ShashankT-ECE/cnn-accelerator/docs/PROJECT_STATE.md

# CNN Accelerator — Project State

## Current Status

### V2 generalized OS accelerator (branch `v2-dev`, `v2/`) — ACTIVE (updated 2026-09-28)

Current work is V2, a generalized INT8 8x8 output-stationary accelerator running LeNet-5 and CIFAR-10 end to end (frozen spec `v2/docs/ARCH_SPEC.md`; decisions `v2/docs/DECISIONS.md` D1–D18; plan `v2/docs/EXPERIMENTS.md`). Target: ROCS 2026 short paper (4 pages + refs, IEEE 2-col, single-blind), deadline 2026-10-09 AoE. The V1 material below is the frozen baseline (`v1-snapshot` / `v1-baseline`).

- **Verified (RTL sim / post-synth netlist sim):** bit-exact logits and cycle-exact agreement with the model on the network, layer, fuzz and checker suites; gate-level netlist sim cycle- and logit-exact; untruncated synthesis-log scan PASS. Counts: `v2/results/verification_stats.csv`.
- **Implementation (post-impl, build fd880d43):** 200, 250 and 300 MHz all close timing with 0 critical warnings. **Performance bitstream = 300 MHz, fallback = 250 MHz** (D14, D18). Numbers: `v2/results/impl_gos.csv`.
- **Results freeze (step 9) done 2026-09-28:** all producers re-run from one clean commit, `check_results.py` ALL CLEAN (results commit 8b8acce).
- **Paper pipeline (step 10):** `v2/paper/scripts/make_all.py` renders every table/figure from the CSVs; board cells are placeholders until hardware rows exist. Model analyses in `v2/analysis/` (utilization, V1-vs-V2 schedule ablation, 16x16 projection labeled "projected", not C1). Reproduction: `v2/REPRODUCE.md`.
- **Power plan:** primary = on-board INA260 SOM rail (VCC_SOM), `v2/board/power_log.py`, label "SOM-rail power (INA260)"; external meter optional cross-check.
- **Laptop-side reviewer gaps closed (2026-09-29):** full-dataset RTL sim 10,000/10,000 images per net bit- and cycle-exact (`rtl_full10k.csv`); publication-grade board sessions (pre-flight, measured PL clock, median + 95% CI, interleaving, repeatability, soak, spread, B2 fit, 300→250 fallback, fast host path, control phase, energy two ways; INA260 only, no external meter); DPU baseline compiled for the prebuilt pynq-dpu 2.5 overlay (`v2/dpu/`).
- **Next:** KV260 board sessions 1–3 + DPU session (`v2/board/session.sh`, `v2/dpu/dpu_session.py`) — nothing has been measured on the board yet; then the paper text.
- **Open questions:** INA260 real update rate and VCC_SOM rail coverage (confirm on the board / schematic); ΔP includes PS activity driving the accelerator.

### V1 (frozen baseline)

The repository baseline and shared development environment documentation are
established.

The project targets the AMD Kria KV260 / XCK26 using SystemVerilog and
Vivado ML 2023.1.

The repository is hosted on GitHub and is the shared source of truth for the
development team.

**Current engineering phase:** V1 systolic array implemented
(`rtl/common/systolic_array.sv`) and verified by its integration testbench
(`sim/tb_systolic_array.sv`, 379/379 checks PASS in Vivado ML 2023.1). Array
compile/elaboration is verified (`xvlog`/`xelab` clean), and the V1 PE remains
verified at 55/55 PASS. The systolic-array RTL + verification milestone is
complete, and DSP48E2 inference is established (1 DSP/PE, 64/array). The V1
Conv1 convolution mapping is resolved as a **row-decomposed 5-pass** schedule
(Decision 9), superseding a withdrawn single-pass 2-D mapping. The
input-feed/line-buffer specification is now unblocked; full array-level
integration (controller/BRAM/input-feed wiring) remains future work.

The V2 reconfigurable-dataflow systolic array (true spatial Weight-Stationary)
is also implemented and verified: `rtl/common/systolic_array_v2.sv` passes
335/335 checks in `sim/tb_systolic_array_v2.sv`, synthesizes to 64 DSP48E2 /
0 CARRY8, and closes timing at 200 MHz with post-route WNS +2.861 ns. Vivado
implements the muxed WS addend through the DSP C input (not PCIN/PCOUT) — see
Decision 12.

### Phase 2 Research Accelerator — COMPLETE (2026-08-21)

The Phase 2 research accelerator (`rtl/common/cnn_accelerator_v2.sv`) is
implemented and verified against the real MNIST-12 Conv1 (SAME-padded, OC=8)
golden model. It wraps the FROZEN V2 datapath (`systolic_array_v2.sv` /
`pe_v2.sv`, unchanged) with new integration logic providing:

- **Runtime OS/WS reconfiguration** on one datapath (Decision 14): 0=OS, 1=WS;
  mode_commit only in IDLE; 8-cycle flush; verified OS→WS and WS→OS bit-exact
  with no reset. OS = 9,184 cycles; WS dense = 38,528 cycles.
- **SAME padding** (zero injection for OOB rows/cols — fixes the Phase-1 clamp
  bug) and **OC=8** (all 8 PE rows in OS; 8 channel sweeps in WS).
- **Genuine coarse zero-skip** (Decision 16): a 5×12 all-zero activation window
  skips the whole WS group. Measured on real MNIST: 85.43% of MACs have zero
  activation; WS drops 38,528 → 18,368 cycles (2.10×). The frozen array's
  array-wide `zero_skip` is tied 0 (per-MAC gating is unsafe — gates the
  *shifted* product) and documented as a limitation.
- Exact `skipped/executed/total` MAC counters (156,800 / 133,960 / 22,840).

Integration testbench `sim/tb_cnn_accelerator_v2.sv` passes **75,305/75,305**
checks (OS/WS bit-exact vs golden, reconfiguration, padding boundaries, OC=8,
sparsity counters, mode interlock). Synthesis/implementation and timing are
recorded in `docs/PHASE2_SYNTHESIS.md`.

### Phase 2 Hardening — COMPLETE (2026-08-21)

The paper-readiness hardening milestone is complete and recorded in
`docs/PHASE2_HARDENING.md` (machine-readable artifacts in `data/benchmark/`).
All changes are localized to the Phase-2 controller (`cnn_accelerator_v2.sv`);
**no frozen module changed** and results remain bit-exact (75,305/75,305,
OS 9,184 / WS 18,368 cycles, counters 133,960/22,840/156,800 unchanged).

- **Timing:** WNS **+0.030 → +0.189 ns** @ 200 MHz (6.3× margin, ~208 MHz max)
  by registering `accum_clear`/`weight_load` at the array boundary, pipelining
  the MAC/cycle counters, expanding `result_base` as shifts (removes 3
  controller DSPs), and `max_fanout` on `s`/`mode_active_r`. Resources: LUT
  11,245→9,372, FF 5,726→5,795, DSP 67→64, CARRY8 20.
- **Fair OS/WS comparison:** OS 9,184 vs WS no-skip 38,528 = 4.195×; mechanism
  is WS channel serialization (8×) vs OS channel parallelism on rows.
- **Sparsity accounting:** 85.43% zero activations → 46.94% skippable MACs →
  52.33% cycle reduction → 2.10× (single image), 1.77× mean over 200 images.
  `zero_skip` per-MAC gating remains tied 0 (unsafe on the frozen array); the
  genuine mechanism is the coarse WS zero-group skip.
- **Accuracy:** FP32 == INT8 == 98.90% (0 flips, SQNR 46.44 dB, 0 clipping) on
  the full 10k test set; checkpoint SHA-256 pinned in `data/vectors/manifest.json`.
- **Reconfiguration:** 8-cycle flush (40 ns @ 200 MHz); OS→WS→OS and WS→OS→WS
  bit-exact, no reset.

### Phase 3 Board Integration — IMPLEMENTED + VERIFIED IN SIMULATION (2026-08-21)

The board-facing AXI4-Lite architecture (Decisions 17–20) is implemented and
verified in simulation; only physical measurement and bitstream generation
remain BOARD-ONLY. See `docs/PHASE3_BOARD_INTEGRATION.md` and
`docs/PHASE3_SYNTHESIS.md`.

- **New RTL:** `rtl/common/cnn_axi_ctrl.sv` (AXI4-Lite slave + result BRAM),
  `rtl/top/cnn_top.sv` (reset conversion + top).
- **New testbench:** `sim/tb_cnn_top_axi.sv` — 17/17 PASS (bit-exact vs golden).
- **New software:** `software/cnn_host.c` (PS UIO driver/benchmark), Makefile.
- **New scripts:** `scripts/run_verification.sh`, `scripts/board/*`
  (overlay + block-design template + firmware shell).
- **Reproducibility:** `golden_canonical.hex` now generated by
  `python/reference/export_vectors.py`; `data/vectors/SHA256SUMS` added;
  manifest `git_sha` re-pinned; `LICENSE` (MIT) added.
- **No frozen module modified.** `cnn_accelerator_v2.sv` gained one
  `sparsity_disable` input (non-frozen integration logic).

## Verified Development Environment

- Host OS: Ubuntu 22.04.5 LTS 64-bit
- Python: 3.10.12
- Vivado ML: 2023.1
- Target device: `xck26-sfvc784-2LV-c`
- PyTorch: 2.1.2+cpu
- torchvision: 0.16.2+cpu
- NumPy: 1.26.4
- Claude Code: 2.1.207
- Graphify: 0.8.39

## Repository Setup

Project-scoped Claude Code configuration is present under `.claude/`.

The shared development setup is documented in `docs/DEVELOPMENT_SETUP.md`.

The Research skill is included under `.claude/skills/research/`.

Generated build and local data must remain outside the committed source where
specified by `.gitignore`.

## Architecture Status

### Architecture Roadmap

The architecture roadmap is available locally at:

`docs/reference/architecture_major_project.pdf`
("CNN Hardware Accelerator on AMD Kria KV260 — Complete Project Reference v3.0")

It is a **local reference only** and has **not** been committed to Git. It is
the high-level project roadmap and initial reference. It is **not** an
authoritative detailed implementation specification.

Do not treat assumptions from the roadmap as finalized requirements.

### PE Specification

The first technical specification has been created and reviewed:

`docs/specs/PE_SPEC.md` — PE Specification (V1 Baseline)

This document records what the roadmap explicitly establishes, what external
research informs, candidate architectures, and open decisions. It uses a label
system: REQUIREMENT, RESEARCH FACT, CANDIDATE, IMPLIED, OPEN DECISION.

### PE Implementation and Verification

The V1 PE is implemented and functionally verified:

- **RTL:** `rtl/common/pe.sv` — implements the finalized V1 contract
  (`docs/specs/PE_SPEC.md` §5–§8; Decisions 1–6).
- **Testbench:** `sim/tb_pe.sv` — self-checking, non-UVM unit testbench.
- **Simulation:** Vivado ML 2023.1 (`xvlog`/`xelab`/`xsim`) — **55/55 checks
  PASS, 0 FAIL**.
- **Verified scenarios:** synchronous reset, weight load/retention/reload,
  signed 8×8 arithmetic and corner cases, 16→32-bit accumulation, repeated and
  back-to-back MAC, combinational activation forwarding, `zero_skip`,
  `result_request` read-without-clear, `accum_clear` pipeline flush, the §5.7
  control-priority combinations, and the finalized pipeline timing.

Synthesis (DSP48E2 inference) is **resolved** — see "Synthesis and DSP48E2
Inference" below. Array-level (`systolic_array.sv`) integration with the
controller/BRAM/input-feed remains future work.

### Systolic Array Specification

The V1 systolic array specification has been drafted:

`docs/specs/SYSTOLIC_ARRAY_SPEC.md` — Systolic Array Specification (V1 Baseline)

It records the resolved V1 dataflow (Decision 7): **Output-Stationary** —
weight-broadcast + activation-shift + local PE accumulation. It defines the 8×8
topology, the row/column mapping, the cycle-level schedule, the array interface,
and the verification requirements. It amends the roadmap's "fixed
weight-stationary" wording as historical/source context.

The five array scheduling decisions (Decision 8 — padding, skew, drain, tap
order, peak-vs-sustained) are also recorded, leaving `systolic_array.sv`
unblocked. The input-feed / line-buffer unit is a separate upcoming module.

### Systolic Array Implementation and Verification

The V1 systolic array is implemented and functionally verified:

- **RTL:** `rtl/common/systolic_array.sv` — an 8×8 grid of 64 verified PEs with
  array-level activation-shift interconnect (7 registers per row), per-row weight
  broadcast, array-wide control fan-out (`weight_load`/`accum_clear`/`zero_skip`),
  and column-sequential result drain. No FSM, no partial-sum cascade, no sparsity
  (per `docs/specs/SYSTOLIC_ARRAY_SPEC.md`).
- **Testbench:** `sim/tb_systolic_array.sv` — self-checking, directed, non-UVM,
  with an independent reference model (`PE(r,c) = Σ_t a_r[t]·w_r[t+c]`, streams
  zero-padded).
- **Simulation:** Vivado ML 2023.1 (`xvlog`/`xelab`/`xsim`) — **379/379 checks
  PASS, 0 FAIL**. Covers synchronous reset, 64-PE structure, activation shift and
  boundary columns, per-row weight broadcast, the one-cycle weight-lead skew,
  signed 8×8 arithmetic, 32-bit accumulation, `zero_skip`, `accum_clear`,
  column-sequential drain + read-without-clear, idle rows 6–7, back-to-back
  groups, and a complete deterministic convolution.
- **Compile/elaboration:** `xvlog -sv` and `xelab` on `pe.sv` + `systolic_array.sv`
  (+ testbench) are clean (0 errors).

The input-feed/line-buffer module is the next major module; full array-level
integration (controller/BRAM/input-feed wiring) remains future work.

### Systolic Array V2 Implementation and Verification

The V2 reconfigurable-dataflow systolic array (true spatial Weight-Stationary,
Decisions 10–11) is implemented and functionally verified:

- **RTL:** `rtl/common/systolic_array_v2.sv` — an 8×8 grid of 64 PE-v2 instances
  (`rtl/common/pe_v2.sv`) with the V1-identical activation shift chain, an
  explicit vertical `psum_in`/`psum_out` cascade, always-on bottom-to-top tile
  feedback (`psum_in[0][c] = psum_out[7][c]`), per-row weight broadcast, and a
  per-row (transposed) result drain that reads row 7. `dataflow_mode`/`zero_skip`
  are array-wide fan-out inputs; no FSM/controller/BRAM is instantiated.
- **Testbench:** `sim/tb_systolic_array_v2.sv` — self-checking, non-UVM, with an
  independent 5×5 valid-convolution golden model (never derived from the V2
  schedule / PE geometry / tile counters).
- **Simulation:** Vivado ML 2023.1 (`xvlog`/`xelab`/`xsim`) — **335/335 checks
  PASS, 0 FAIL**. Covers reset, weight load/hold, per-row diagonal skew, the
  vertical psum cascade (row-to-row / 2-PE / 8-row), all four tile partials at
  cycles 17/25/33/41, bottom-to-top tile feedback, tile-3 single tap, result
  capture timing, signed 8×8 corners, 32-bit accumulation, randomized cases, all
  8 output columns, boundary cases, multiple output rows, and multiple
  kernels/channels.
- **Compile/elaboration:** `xvlog -sv`/`xelab` clean (0 errors).

This establishes the true spatial Weight-Stationary dataflow (Decision 10) and
the Conv1 WS mapping (Decision 11) at array level. The controller/input-feed
internals that realize the §9 schedule remain future work.

### Systolic Array V2 Synthesis and DSP Mapping

- **DSP48E2 = 64** (1/PE), **CARRY8 = 0**, **BREG=1 / MREG=1 / PREG=1** for all
  64; AREG = 0/1/2 (activation shift-chain absorption, same mechanism as V1).
- **DSP addend mapping (RESOLVED):** the muxed WS addend (`psum_in + product`) is
  implemented through the DSP48E2 **C input** (OPMODE "C or P"), **not** the
  PCIN/PCOUT cascade, because the `dataflow_mode` mux prevents PCIN/PCOUT
  inference (confirmed in `build/dsp_probe/`: the mux-free `pe_ws` infers
  `PCIN+(A*B)`, the muxed `pe_dual` infers `(C or P)+(A*B)`). PCIN/PCOUT is an
  implementation detail, not a V2 functional requirement: the vertical psum
  reduction and bottom-to-top feedback are functionally verified and timing-clean
  regardless of which DSP input carries the addend. No PE redesign is required
  (Decision 12).
- **Post-route timing (200 MHz baseline):** WNS **+2.861 ns**, TNS 0 ns,
  WHS +0.073 ns, THS 0 ns, 0 failing endpoints, no congestion above level 5,
  0 unrouted nets. Critical path = the row-7 → row-0 tile-feedback hop via the
  C input (2.095 ns data delay, 2 logic levels). Resources: 64 DSP48E2 / 1,032
  LUT / 2,368 FF / 0 CARRY8 / 0 BRAM / 0 URAM.

### Synthesis and DSP48E2 Inference

DSP48E2 inference for the V1 PE and 8×8 array is established and verified
(Vivado ML 2023.1, target `xck26-sfvc784-2LV-c`):

- **Baseline (default synthesis):** Vivado's default `use_dsp = "auto"` mapped
  the signed 8×8 PE MAC entirely to fabric — **0 DSP48E2**, 97 LUT / 12 CARRY8
  per PE (array: 0 DSP, 7,054 LUT / 5,632 FF / 768 CARRY8). The 8×8 operands
  fall below Vivado's auto-DSP threshold (a DSP48E2 27×18 multiplier would be
  ~94% idle).
- **Root cause (controlled probes):** an 8×8 multiply and an 8×8 MAC each infer
  0 DSP48E2 under default synthesis; an explicit `(* use_dsp = "yes" *)` (or
  ≥16-bit operands) is required to obtain DSP48E2 inference. The PE's control
  gating (`rst`/`accum_clear`/`zero_skip`) is **not** the blocker.
- **Fix:** `rtl/common/pe.sv` adds a targeted `(* use_dsp = "yes" *)` attribute
  on the `product` datapath. No other behavioural change.
- **Single PE synthesis:** exactly **1 DSP48E2** — `AREG=0, BREG=1, MREG=1,
  PREG=1` (weight→BREG, product→MREG, accumulator→PREG, combinational
  activation→AREG=0). Fabric drops to 2 LUT / 0 CARRY8 / 32 FF (result_out
  only).
- **8×8 array synthesis:** exactly **64 DSP48E2** (1 per PE), 1,039 LUT /
  2,048 FF / 0 CARRY8 / 0 BRAM / 0 URAM. All DSPs use BREG=1, MREG=1, PREG=1;
  in the array Vivado may absorb the activation shift-chain registers into the
  DSP AREG inputs (observed AREG = 0/1/2 across columns), so AREG is not
  uniformly 0 at array level — functionally equivalent.
- **Functional verification unchanged:** `tb_pe` 55/55 PASS and
  `tb_systolic_array` 379/379 PASS (the attribute is a synthesis hint only;
  simulated behaviour is identical).

**RESOLVED:** DSP48E2 inference for the V1 PE/array is confirmed (1 DSP/PE,
64/array). Numerical format, accumulator width, and cycle-level behaviour are
unchanged.

### Post-Route Implementation Baseline

A baseline post-synthesis/post-route implementation of the V1 8×8 array was run
(Vivado ML 2023.1, top `systolic_array`, target `xck26-sfvc784-2LV-c`). This is
a timing/implementation baseline only — no RTL, pipeline, or constraint-source
changes were made.

- **Clock target (analysis only):** 200 MHz (5.000 ns), applied as a baseline
  constraint in the generated build flow only. This is **not** a finalized
  project clock requirement — the clock frequency target remains an open
  decision (`PE_SPEC.md` §11.6) until the controller/BRAM/input-feed
  integration is timed.
- **Implementation mode:** out-of-context (OOC). The flat `systolic_array`
  top exposes 397 I/O ports (256-bit `result_out` + 128 data inputs + control),
  which exceeds the ~189 bonded I/O sites available on the KV260/XCK26 package.
  This is expected: the array is a datapath sub-block intended to be driven by
  an on-chip controller/BRAM/PS-AXI interface, not by package pins. OOC isolates
  the internal register-to-register timing of the array core.
- **Post-route DSP count:** 64/64 DSP48E2 remain present after
  placement/routing.
- **DSP register configuration:** BREG=1, MREG=1, PREG=1 for all 64 DSPs.
- **AREG distribution:** AREG=0 × 8, AREG=1 × 40, AREG=2 × 16. The AREG=1/2
  DSPs reflect the array's activation shift-chain registers being absorbed into
  the DSP A-input registers (AREG absorption); the inter-column activation
  movement is realized via the DSP48E2 ACOUT→ACIN cascade.
- **Critical setup path:** DSP48E2_X11Y11 → DSP48E2_X11Y12, the DSP
  ACOUT→ACIN activation cascade between adjacent columns. The path is
  routing-dominated (~66% route vs ~34% logic of the 1.471 ns data delay, 0
  logic levels) and currently closes at the 200 MHz baseline target.
- **Post-route timing (200 MHz baseline):** WNS +2.772 ns, TNS 0 ns,
  WHS +0.115 ns. Setup, hold, and pulse-width constraints are all met (0 failing
  endpoints). 200 MHz closes with margin (~449 MHz setup-limited capability,
  with OOC clock skew estimated).
- **Resources (post-route):** 64 DSP48E2, 1,032 LUT, 2,048 FF, 0 CARRY8,
  0 BRAM, 0 URAM. The 2,048 FFs are the 64×32 `result_out` registers only; all
  other datapath registers (weight/product/accumulator/shift) live inside the
  DSPs.

**RESOLVED:** the V1 array datapath is timing-clean at the 200 MHz baseline and
DSP48E2 inference (64/64) is preserved through implementation.

## Decisions

### Established V1 PE Requirements (from Roadmap)

The architecture roadmap (§3.2, §4) establishes these V1 PE requirements:

- activation input
- weight input
- activation × weight multiplication
- internal accumulation
- FSM-controlled result exposure
- registered output
- zero_skip input port with functional bypass behaviour (port in V1;
  functional connection is Team A V2)
- 8×8 systolic grid (64 PE instances); activations shift across rows,
  weights shift down columns
- V1 baseline dataflow: Weight-Stationary (weights held in place,
  activations shift)

These are recorded in `docs/specs/PE_SPEC.md` §3.1 as R1–R9.

> Note: the "Weight-Stationary" dataflow label above is the roadmap's original
> wording. The V1 array dataflow was subsequently reclassified to
> Output-Stationary — see Decision 7.

### Numerical Format Status

**Decision 1 — Numerical Format — RESOLVED (2026-08-10).**

The V1 PE uses **signed 8-bit two's-complement integers** for both activation
and weight operands. The implicit scale factor is 1/256 (2^(-8)), making the
representable real range [-0.5, +0.49609375] with resolution 0.00390625.

This is the roadmap's "Q8" working assumption (§5.3), formally adopted as the
V1 numerical format.

| Parameter | Value |
|---|---|
| Activation operand | signed 8-bit two's-complement |
| Weight operand | signed 8-bit two's-complement |
| Operand width | 8 bits |
| Product width | 16 bits (full precision, not truncated inside PE) |
| Fixed-point interpretation | external to PE (array output / drain path) |
| Weight extraction | `w_fixed = clip(round(w × 256), -128, 127)` per roadmap §5.3 |

**Rationale:** consistent with roadmap weight extraction; minimal PE datapath
complexity (integer MAC only); optimal DSP48E2 mapping (one DSP/PE with 27×18
headroom); efficient BRAM usage (8 bits/weight); LeNet-5/MNIST accuracy loss
negligible with 8-bit quantization; preserves Q8→INT8 future-work pathway.

**Known risk:** weights with magnitude ≥ 0.5 are clipped. The team should
measure actual LeNet-5 weight distributions to assess accuracy impact.

### Decision 2 — Accumulator Width — RESOLVED (2026-08-10)

The V1 PE uses a **32-bit signed two's-complement accumulator**.

| Parameter | Value |
|---|---|
| Accumulator width | 32 bits signed |
| Minimum required (LeNet-5 conv1, N=25) | 21 bits |
| Industry standard (TPU, FINN, Jacob 2018) | 32 bits |
| Overflow threshold (worst-case products) | >131,000 |
| LeNet-5 worst case (FC1, N=400) | ~400 |
| DSP48E2 internal | 48 bits (native, "free") |

**Rationale:** Industry standard for 8-bit MAC arrays. 328× safety margin over
LeNet-5 worst case. Natural power-of-two width. DSP48E2 uses 48 bits
internally regardless; 32-bit RTL width governs behavioral simulation and PE
output routing. The exact per-PE accumulation depth (N_max_acc = 25 for conv1)
is not required to justify 32 bits — the margin is so large that any plausible
V1 mapping is safe.

### Decision 3 — Overflow Behaviour — RESOLVED (2026-08-10)

**No overflow handling logic in the V1 PE. Overflow is mathematically
impossible by construction.**

With 32-bit signed accumulator and 8-bit signed operands (max |product| =
16,384), the accumulator permits >131,000 worst-case accumulations before
overflow. LeNet-5 requires at most ~400 accumulations per PE. The safety
margin is 328×.

No wrap, saturation, or overflow-flag logic is implemented. The DSP48E2's
native 48-bit internal accumulator provides additional headroom internally.

### Decision 4 — Result-Read Protocol — RESOLVED (2026-08-10)

**FSM-driven strobe protocol with read-without-clear semantics.**

| Parameter | Value |
|---|---|
| FSM→PE signal | `result_request` (1 bit) |
| PE→FSM signal | `result_out` (32 bits, registered) |
| Accumulator clear | `accum_clear` (1 bit, separate from result_request) |
| Read semantics | Read-without-clear |
| Flow control | None in PE — FSM controls timing globally |
| Array-level drain | Column-sequential (8 PEs/cycle, 16 cycles: 2/column), outside PE scope |

**Rationale:** Simplest mechanism satisfying R5. Read-without-clear is
universal across all surveyed systolic accelerators. Separate `accum_clear`
preserves debugging capability. No valid/ready handshake in PE — consistent
with the roadmap's FSM-driven architecture.

### Decision 5 — Reset Semantics — RESOLVED (2026-08-10)

**Synchronous reset, active-high polarity (`rst`).**

| Parameter | Value |
|---|---|
| Synchronicity | Synchronous (`always_ff @(posedge clk)`) |
| Polarity | Active-high (`if (rst)`) |
| Registers reset | accumulator, weight, result_out |
| DSP48E2 mapping | Direct (native synchronous reset) |

**Rationale:** DSP48E2 registers support synchronous reset only (UG579, UG949).
Async reset would force MAC registers into fabric (~65 extra FFs + ~32 extra
LUTs per PE per UG949 example). Active-high matches DSP48E2 native reset
polarity. The roadmap's Skill 1 `negedge rst_n` is explicitly a code-gen
example, not a project requirement (per PE_SPEC.md §11.8).

### Decision 6 — Pipeline / Cycle Architecture — RESOLVED (2026-08-10)

**Registered MAC with combinational activation forwarding. Fixed depth.**

| Parameter | Value |
|---|---|
| MAC pipeline | DSP48E2-inferred, MREG=1, PREG=1 |
| MAC latency | 2 cycles (activation-in → accumulator-update) |
| Activation forwarding | Combinational (`act_out = act_in`, 0-cycle delay) |
| Weight register | 1 stage (`weight <= weight_in` on `weight_load`) |
| Result output | 1 stage (`result_out <= accumulator` on `result_request`) |
| Throughput | 1 MAC/cycle/PE (steady state) |
| Parameterization | Fixed (not parameterized for V1) |

**Rationale:** Simplest architecture satisfying all requirements (R1–R9).
MREG=1 is essential for timing and power (Xcell87). Combinational forwarding
eliminates pipeline alignment complexity. 2-cycle latency acceptable for CNN
inference (throughput matters, not latency). DSP48E2 inferred from behavioral
RTL. Fixed depth avoids premature parameterization.

### Decision 7 — V1 Dataflow Reclassification — RESOLVED (2026-08-17)

**The V1 array dataflow is Output-Stationary, not fixed spatial
Weight-Stationary.**

The architecture roadmap (§3.2, §4) describes V1 as "fixed weight-stationary:
weights held in place, activations shift." The finalized PE
(`rtl/common/pe.sv`) has a pinned local accumulator and no `psum_in`/`psum_out`
partial-sum path, so a literal fixed-weight dataflow would compute
`weight × Σ activations`, which is not a convolution. The completed array
specification (`docs/specs/SYSTOLIC_ARRAY_SPEC.md` §3) therefore establishes:

| Parameter | Value |
|---|---|
| V1 dataflow | Output-Stationary (tap-serial) |
| Weight movement | broadcast per row, reloaded every tap |
| Activation movement | shift across columns (array-level registers) |
| Partial-sum path | none in V1 |
| PE status | unchanged, verified (55/55) |
| True spatial Weight-Stationary | deferred to V2 / PE v1.1 (psum cascade) |

This **replaces** the earlier interpretation of V1 as fixed spatial
Weight-Stationary. The roadmap's "weight-stationary" wording is preserved as
historical/source context; the roadmap did not originally specify
Output-Stationary. This is an explicit architectural decision, not a silent
relabeling.

**Rationale:** the Output-Stationary mapping (weight-broadcast +
activation-shift + local accumulation) is the only dataflow that is both
mathematically correct for convolution and compatible with the locked PE; it
sustains one MAC/cycle/PE after pipeline fill. See
`docs/specs/SYSTOLIC_ARRAY_SPEC.md` §3 and §9.

### Decision 8 — V1 Array Scheduling Decisions — RESOLVED (2026-08-17)

Five array scheduling decisions are finalized (see
`docs/specs/SYSTOLIC_ARRAY_SPEC.md` §10, §11, §14–§17). `systolic_array.sv` is
now unblocked.

| # | Decision | Resolution | Rationale |
|---|---|---|---|
| 1 | Conv1 output dimension / padding | 24×24 valid (no padding) | Standard LeNet-5/MNIST; 24 = 3×8 → no partial tile |
| 2 | Weight/activation skew | weight stream leads activation by one cycle | Absorbs the PE BREG stage; §16 schedule |
| 3 | Result drain | column-sequential, 16 cycles (2/column) | Matches `result_request` protocol; 256-bit bus |
| 4 | Tap serialization | row-major `t = K·k_y + k_x` | Deterministic; shared by weight ROM and input feed |
| 5 | "64 MACs/cycle" | peak capability, not sustained | Conv1 sustains 48 (6 rows); rows 6–7 idle (75%) |

> **Amended by Decision 9 (2026-08-17):** items 4 and 5 above (single-pass
> row-major tap serialization; "48 MACs/cycle sustained") were found
> mathematically inconsistent / unjustified and are superseded. See Decision 9
> and `SYSTOLIC_ARRAY_SPEC.md` §20.4.

**Note:** the input-feed / line-buffer unit is a **separate upcoming module**
with its own specification. Its interface to the array (`act_in` sequence, tap
order, skew) is fully defined by the array spec; only its internals remain.

### Decision 9 — V1 Convolution Mapping (Row-Decomposed 5-Pass) — RESOLVED (2026-08-17)

The V1 Conv1 5×5 convolution is computed as **five sequential 1-D horizontal
passes**, one per kernel row `k_y = 0..4`, replacing the earlier single-pass
25-tap 2-D mapping.

| Parameter | Value |
|---|---|
| Convolution structure | 5 sequential 1-D passes (one per kernel row `k_y`) |
| Pass `k_y` | 1-D 5-tap horizontal correlation along input row `y + k_y` |
| Taps per pass | 5 (`k_x = 0..4`) |
| Accumulation | PE accumulator preserved across the 5 passes |
| `accum_clear` | only before pass 0 of a new output group |
| Result read | `result_request` after pass 4 (the 5th pass) |
| PE / array RTL | **unchanged** |

**Correction of a previous inconsistency.** The prior single-pass 25-tap 2-D
mapping (recorded in `SYSTOLIC_ARRAY_SPEC.md` §10.1/§16 and Decision 8) was
found **mathematically inconsistent** during the input-feed/line-buffer
specification work: with in-phase weight broadcast, a single shared activation
stream, and a 7-deep shift chain, the required activation value at one cycle
would have to equal two different input pixels. Numerical verification confirmed
column 0 correct and columns 1–7 incorrect. This is recorded as a **withdrawn
mapping** (with audit trail) in `SYSTOLIC_ARRAY_SPEC.md` §20.4 — not silently
relabelled.

**Why the error was not caught.** `sim/tb_systolic_array.sv`'s convolution test
(T11) used a 1-D 5-tap stimulus, which exercised the array mechanics but not the
2-D kernel-row boundary behaviour where the inconsistency occurs.

**Scope.** `rtl/common/pe.sv` and `rtl/common/systolic_array.sv` are unchanged;
the array performs a 1-D 5-tap correlation per pass and is unaware of the 2-D
structure. The controller/input-feed orchestrates the five passes.

**Storage and throughput are NOT finalized.** The input-feed's physical storage
(BRAM/URAM/distributed RAM) and the sustained throughput are not claimed here;
they must be derived from the input-feed/line-buffer specification (now
unblocked). The only derived storage fact is the 5×5 window data-span minimum
`(5−1)·28 + 5 = 117` pixels, treated as a data-availability lower bound, not a
physical line-buffer size.

**Rationale:** reuses the already-verified 1-D array behaviour directly; changes
only the controller/weight/activation schedule; no PE or array RTL change.

### Decision 10 — V2 Reconfigurable Dataflow (True Spatial Weight-Stationary) — RESOLVED (2026-08-18)

**V2's reconfigurable-dataflow mode is true spatial Weight-Stationary (WS).**
PE-v2 adds the partial-sum cascade ports required to implement it, and the V1
RTL is frozen and untouched.

| Parameter | Value |
|---|---|
| V2 WS dataflow | weights held in PEs + activation shift + vertical `psum_in`/`psum_out` cascade |
| Cross-tile reduction | bottom-to-top tile feedback (per-column feedback registers + row-0 mux) |
| PE-v2 added ports | `psum_in[31:0]` (input), `psum_out[31:0]` (output), `dataflow_mode` (input) |
| WS accumulator | `accumulator <= psum_in + product` (pass-through) |
| OS accumulator | `accumulator <= accumulator + product` (V1-identical) |
| Control priority | unchanged (`PE_SPEC.md` §5.7) |
| OS mode | behaviourally equivalent to V1 (`dataflow_mode = 0`) |

**V1 RTL frozen.** `rtl/common/pe.sv`, `rtl/common/systolic_array.sv`,
`rtl/common/input_feed.sv`, and the V1 testbenches (`sim/tb_pe.sv`,
`sim/tb_systolic_array.sv`, `sim/tb_input_feed.sv`) are **frozen and are not to
be modified** for V2. V2 introduces a new PE variant (PE-v2) and array-v2 rather
than editing the V1 modules.

**Why this supersedes the roadmap wording.** The roadmap §3.2 describes V2
"Mode 0 Weight Stationary" as "weights held, activations shift" with no partial
sums. Taken literally that computes `w × Σ activations`, which is not a
convolution (the same error withdrawn in Decision 9 / `SYSTOLIC_ARRAY_SPEC.md`
§20.4). True spatial WS requires the partial-sum cascade that Decision 7
deferred. PE-v2 adds the minimum ports so the array can reduce a 1-D dot product
across the vertical cascade and, via bottom-to-top tile feedback, deeper
reductions (e.g. Conv1's 25 taps across 4 tiles of ≤8). This is an explicit
decision, not a silent extension of the V1 PE.

**Contract.** The PE-v2 port list and accumulator semantics are specified in
`docs/specs/PE_SPEC.md` §13.

**Open V2 array-level items (not resolved by this decision):** WS weight-loading
mechanism, WS activation delivery, WS result collection, the reconfiguration
flush sequence, and DSP48E2 inference of the mode mux / PCIN–PCOUT cascade.

### Decision 11 — V2 WS Conv1 Mapping — RESOLVED (2026-08-19)

**The V2 Weight-Stationary Conv1 mapping is resolved** (see
`docs/specs/SYSTOLIC_ARRAY_V2_SPEC.md`). The earlier idea of mapping the **6
output channels onto PE rows 0–5** is **WITHDRAWN**: the PE-v2 vertical
`psum_in → psum_out` cascade **sums rows**, so rows-as-channels would produce
`Σ output[ch]` — the sum of six distinct channels, not six independent results.
In WS mode rows must therefore represent the **reduction/tap** dimension.

| Parameter | Value |
|---|---|
| PE rows 0–7 | kernel tap / reduction dimension (8 taps per tile) |
| PE columns 0–7 | 8 output pixels, V1 reverse-index mapping (`base − c`) |
| Output channels | serialized — one channel per sweep (6 sweeps for Conv1) |
| 25 taps | 4 WS tiles: 8 + 8 + 8 + 1 |
| Within a tile | `psum_in → psum_out` performs the vertical reduction |
| Bottom row | produces the running tile partial sum |
| Cross-tile feedback | bottom-to-top: `PE(0,c).psum_in = PE(7,c).psum_out` |
| Final result | bottom row (row 7), one completed output per column |

**Compatibility verified:** the bottom-to-top feedback is a valid systolic ring
(8 accumulator registers around the loop, no combinational loop) and is
realizable with the already-verified `rtl/common/pe_v2.sv` with **no PE change**;
`weight_load` reloads tap weights between tiles in both modes, and `accum_clear`
is asserted once per sweep (never between tiles), mirroring V1's pass sequencing.
The *cycle-level schedule* (V2 spec §9) and the `systolic_array_v2.sv`
interconnect are now implemented and verified (335/335; see Decision 12).

**Why this is a transposition, not a new datapath:** V1 holds channels on rows
and serializes taps in time; V2 WS holds taps on rows and serializes channels in
time. Columns (pixels) and the reverse index are unchanged; the V1 output-group
shape (6 × 8 = 48 results) is preserved.

### Decision 12 — V2 WS DSP Cascade Mapping (C input, not PCIN/PCOUT) — RESOLVED (2026-08-19)

**The V2 WS partial-sum cascade is implemented through the DSP48E2 C input, not
the PCIN/PCOUT cascade.** This resolves the "DSP48E2 inference of the mode mux /
PCIN–PCOUT cascade" verification gate (`PE_SPEC.md` §13.6 #5,
`SYSTOLIC_ARRAY_V2_SPEC.md` §10 #4).

| Parameter | Value |
|---|---|
| V2 WS dataflow | true spatial Weight-Stationary (Decisions 10–11) |
| Vertical psum reduction + tile feedback | functionally verified (335/335 array PASS) |
| WS addend DSP mapping | C input (OPMODE "C or P"), NOT PCIN/PCOUT |
| Root cause | the `dataflow_mode` mux prevents PCIN/PCOUT inference (mux-free `pe_ws` infers `PCIN+(A*B)`; muxed `pe_dual` infers `(C or P)+(A*B)`) |
| PCIN/PCOUT status | implementation detail, not a V2 functional requirement |
| PE redesign | not required |

**Why no change is made.** The `dataflow_mode` mux is the defining "reconfigurable
dataflow" feature of PE-v2; removing it to force PCIN/PCOUT would break OS↔WS
reconfigurability. The C-input mapping is functionally identical, synthesizes to
64 DSP48E2 / 0 CARRY8, and closes at 200 MHz (WNS +2.861 ns). No PE-v2 or
array-v2 redesign is warranted.

### Decision 13 — V2 Controller/Input-Feed Decisions — RESOLVED (2026-08-20)

The four remaining V2 array-level open items (result collection, weight loading,
reconfiguration flush, and tap flattening) are resolved against the frozen PE-v2
/ array-v2 interfaces and the verified 42-cycle/group schedule
(`docs/specs/SYSTOLIC_ARRAY_V2_SPEC.md` §9). Each uses the smallest V2-compatible
choice and adds **no new array or PE port**; no RTL is modified.

| # | Item | Resolution |
|---|---|---|
| 1 | Result collection | Reuse the existing per-row `result_req`: assert `result_req[7]` (row 7) for **one cycle** at cycle 41; capture `result_out[0:7]` at cycle 42. No dedicated bottom-row bus (it would modify the frozen array-v2). |
| 2 | Weight loading | Reuse `w_in[0:7]` + the single array-wide `weight_load` at cycles 0/15/23/31; per-tap weights from a small deterministic weight store (LUTROM/register file, ~150 weights ≈ 1.2 kb — no BRAM/URAM). The physical memory primitive is an input-feed implementation detail. |
| 3 | Reconfiguration flush | `accum_clear` at the group/sweep boundary (cycle 0) is the reconfiguration flush; full `rst` is the power-on reset only. `accum_clear` is **never** asserted between tiles (the ring must be preserved). |
| 4 | Tap flattening | **Row-major** `k = 5·k_y + k_x` (fixed, not just a working convention). Minimizes the input-feed's live-row window (≤3 kernel rows per tile vs 5 for column-major) and is already the verified golden-model order. |

These four close `SYSTOLIC_ARRAY_V2_SPEC.md` §10 items 1/2/3/5 and `PE_SPEC.md`
§13.6 items 1/3/4 (§13.6 item 2 was already resolved by §9.5; §13.6 item 5 by
Decision 12). The V2 controller/input-feed RTL that realizes the §9 schedule is
now unblocked; only its internals (activation line-buffer sizing, weight-store
primitive) remain future work.

### Decision 14 — Phase 2 Controller Architecture — RESOLVED (2026-08-21)

**The Phase 2 research accelerator is a single new integration module
(`rtl/common/cnn_accelerator_v2.sv`) driving the frozen `systolic_array_v2` in
both OS and WS modes, with SAME padding and OC=8.** No frozen module is
modified.

| Parameter | Value |
|---|---|
| Dataflow select | `dataflow_mode` (0=OS, 1=WS), latched to `mode_active` |
| Mode switch | `mode_commit` honoured only in IDLE; 8-cycle flush (`accum_clear` + 7-cycle shift-chain drain); no `rst` |
| OS mapping | rows = 8 output channels; 5-pass row-decomposed (Decision 9); 82 cyc/group × 112 groups = 9,184 cycles |
| WS mapping | rows = 8 taps/tile, 4 tiles; channels serialized (8 sweeps); 43 cyc/group × 896 groups = 38,528 cycles |
| Padding | zero injection via `row_ok`/`col_ok` predicate on the stream address (`-2` row/col offset) |
| OC=8 / 28×28 | 4 groups/row; `base = 7,15,23,31`; last group partial (4 valid pixels) |
| Result index | flat leftmost-pixel index `ch*784 + y*28 + (base-7)` (unambiguous for `base=31`) |

### Decision 15 — Result Encoding — RESOLVED (2026-08-21)

The result word carries `result_base = ch*784 + y*28 + (base-7)` (the group's
**leftmost** pixel flat index). A naive rightmost encoding
(`… + base`, `base=31`) overflows into the next row and is ambiguous; the
leftmost encoding (`base-7 ∈ {0,8,16,24}`) never overflows.

### Decision 16 — Sparsity Mechanism — RESOLVED (2026-08-21)

The frozen array's `zero_skip` is **array-wide** and gates the **product**
register, which samples the **shifted** activation (`act_delayed`), not the fed
stream. Gating it on the fed stream (`act_out==0`) zeroes legitimate in-flight
products (verified: sparse MNIST fails bit-exact). Therefore:

| Parameter | Value |
|---|---|
| `zero_skip` | tied to 0 (per-MAC gating unsafe on frozen array — documented) |
| Genuine mechanism | **coarse zero-group skip**: skip a WS group whose 5×12 activation window is all-zero (detected via a 784-bit non-zero mask maintained on image write) |
| Measured MNIST | 85.43% zero-activation MACs; 60/112 positions all-zero; WS 38,528 → 18,368 cycles (2.10×) |
| Counters | `total_macs`=156,800, `skipped_macs`=133,960, `executed_macs`=22,840, `cycle_count`, `zero_skip_cycles` |
| Rejected | fine-grained compaction (breaks fixed systolic timing) |

### Decision 17 — Measured WS-dense via `sparsity_disable` — RESOLVED (2026-08-21)

**A `sparsity_disable` control input is added to `cnn_accelerator_v2` (Phase-2
integration logic — not frozen), so the Weight-Stationary no-skip cycle bound is
MEASURED in simulation rather than asserted analytically.** Default 0 preserves
the coarse zero-group skip; `sparsity_disable=1` forces WS to run all 896 groups.

| Parameter | Value |
|---|---|
| WS dense (sparsity_disable=1) | **38,528 cycles, bit-exact [SIMULATION]** |
| WS sparse (sparsity_disable=0) | 18,368 cycles [SIMULATION] |
| OS dense | 9,184 cycles [SIMULATION] |
| Effect on the frozen datapath | none (2-input AND on the `ws_skip` predicate) |

This converts the paper's central WS-dense row from `[ANALYTICAL] no-skip bound`
to `[SIMULATION] sparsity_disable=1`, closing the "WS-dense is analytical not
measured" reproducibility gap. `benchmark_matrix.json` provenance updated.

### Decision 18 — A1 fair-WS ablation resolved by analysis — RESOLVED (2026-08-21)

**The `A1` "pipelined-V2" ablation (`RESEARCH_READINESS_PLAN.md` §1/§11) is
resolved by analysis, not implementation.** The Phase-2 WS bubble analysis
(`PHASE2_HARDENING.md` §3) shows the only recoverable bubble is group-boundary
pipelining = 1 cycle/group ≈ 2.3%, which cannot change the 4.195× OS-vs-WS
conclusion (whose mechanism is 8× channel serialization vs ~1.9× shorter group).
Implementing a schedule change for a 2.3% effect is neither technically safe
(risk to bit-exactness) nor scientifically necessary (the conclusion is robust).
The like-for-like comparison is already fair: OS-on-array-v2 is bit-identical to
V1 (`pe_v2.sv` OS mode), on the same 64 DSP48E2 / same clock / same golden.

### Decision 19 — Board-facing AXI4-Lite architecture — RESOLVED (2026-08-21)

**The board-facing architecture wraps the verified accelerator in an AXI4-Lite
slave** (per `RESEARCH_READINESS_PLAN.md` §7 Option A, §8): `cnn_axi_ctrl.sv`
(slave + register file + result BRAM + accelerator instance) and `cnn_top.sv`
(`aresetn`→`rst` conversion). Details in `docs/PHASE3_BOARD_INTEGRATION.md`.
Runtime OS↔WS switching is now reachable by software via `DATAFLOW_MODE` +
`CONTROL.MODE_COMMIT` (previously only by testbench pins). Verified 17/17 PASS
in `sim/tb_cnn_top_axi.sv` (image/weight AXI load, OS/WS/WS-dense cycle counts
9,184/18,368/38,528, 6,272/6,272 bit-exact per mode, runtime switch, counters).

### Decision 20 — Result storage (8-bank canonical BRAM) — RESOLVED (2026-08-21)

**Results are stored in 8 single-write-port BRAMs, one per column residue
`x & 7`, at dense address `flat >> 3`** (`flat = ch*784+y*28+x`). Pixel `c` of a
result word maps to bank `7-c`, dense `(result_base+7-c)>>3`. This gives 8
parallel single-write ports (1 result word/cycle, no FIFO/backpressure) and
re-orders results into canonical order in hardware, so host software reads
straight through with **no reverse-index decode**. The group-leftmost column is
`result_base % 28` (784 = 28·28); pixel validity is `left ≤ 20+c`.

### Decision 21 — License — RESOLVED (2026-08-21, changeable)

**The repository now carries an MIT license** (`LICENSE`), matching the MIT
ONNX-MNIST-12 checkpoint and the norm for academic FPGA code. This is a
low-risk default for publication-ready redistribution; the team may choose a
different license before first public release.

### Unresolved PE Decisions

The following decisions block `rtl/common/pe.sv` implementation (see
`docs/specs/PE_SPEC.md` §11–§12 for full context):

1. ~~Numerical format finalisation~~ **RESOLVED (2026-08-10)**
2. ~~Accumulator width~~ **RESOLVED (2026-08-10) — 32-bit signed**
3. ~~Product representation~~ **RESOLVED — 16-bit full precision (consequence of Decision 1)**
4. ~~Overflow behaviour (or explicit waiver)~~ **RESOLVED (2026-08-10) — overflow impossible by construction**
5. ~~Result-read protocol (FSM↔PE handshake)~~ **RESOLVED (2026-08-10) — result_request strobe, read-without-clear**
6. ~~Reset semantics (polarity, synchronicity)~~ **RESOLVED (2026-08-10) — synchronous, active-high (rst)**
7. ~~Pipeline depth / cycle-level behaviour~~ **RESOLVED (2026-08-10) — registered MAC, combinational forwarding, fixed depth**

These are **not** finalized:
- clock frequency target
- exact RTL signal names
- `wgt_out` port
- V2 dataflow-controller extensibility hooks

### V1 / V2 Distinction

- **V1** is the shared baseline: **Output-Stationary** dataflow
  (weight-broadcast + activation-shift + local accumulation), no sparsity
  (Decision 7).
- **True spatial Weight-Stationary** (partial-sum cascade, `psum_in`/`psum_out`)
  is the V2 reconfigurable-dataflow mode — **DECIDED (Decision 10, 2026-08-18)**,
  superseding the earlier "deferred to V2 / PE v1.1" status. PE-v2 adds
  `psum_in`/`psum_out`/`dataflow_mode`.
- **Team B reconfigurable dataflow** (per-layer WS/OS mode switching) is a V2
  extension; its Weight-Stationary mode uses the psum cascade defined by
  Decision 10.
- **Team A sparsity** is a V2 extension. The V1 PE has the `zero_skip`
  port, but its functional connection to the Sparsity Manager is a V2
  Team A concern.

### Previously Undecided — Now Established

| Parameter | Previous Status | Current Status |
|---|---|---|
| PE count | Undecided | **Established:** 64 (8×8 grid) per roadmap §3.2 |
| V1 dataflow mode | Undecided | **Established:** Output-Stationary (weight-broadcast + activation-shift + local accumulation) per Decision 7; roadmap §3.2 "weight-stationary" wording superseded |
| Numerical format | Undecided | **Established:** Signed 8-bit two's-complement, scale 1/256 (Decision 1, 2026-08-10) |
| Accumulator width | Undecided | **Established:** 32-bit signed two's-complement (Decision 2, 2026-08-10) |
| Overflow behaviour | Undecided | **Established:** Overflow impossible by construction; no handling logic (Decision 3, 2026-08-10) |
| Result-read protocol | Undecided | **Established:** result_request strobe, read-without-clear, separate accum_clear (Decision 4, 2026-08-10) |
| Reset semantics | Undecided | **Established:** synchronous, active-high (rst) (Decision 5, 2026-08-10) |
| Pipeline architecture | Undecided | **Established:** registered MAC (MREG+PREG), combinational forwarding, fixed depth (Decision 6, 2026-08-10) |
| PE forwarding direction | Undecided | **Established:** activations shift across rows per roadmap §3.2 |
| Conv1 output dimension | Undecided | **Established:** 24×24 valid, no padding (Decision 8, 2026-08-17) |
| Weight/activation skew | Undecided | **Established:** weight stream leads activation by one cycle (Decision 8, 2026-08-17) |
| Result drain | Undecided | **Established:** column-sequential, 16 cycles (2/column) (Decision 8, 2026-08-17) |
| Kernel serialization | Undecided | **Established:** row-major `k_y, k_x` indexing, **decomposed into 5 passes** (Decision 9, 2026-08-17; amends the withdrawn single-pass 25-tap stream) |
| "64 MACs/cycle" meaning | Undecided | **Established:** peak capability; sustained throughput re-derived under the 5-pass mapping (Decision 9, 2026-08-17) |
| Conv1 convolution mapping | Incorrect (single-pass 2-D) | **Established:** row-decomposed 5-pass, one 1-D pass per kernel row (Decision 9, 2026-08-17) |

## Open Questions

Record unresolved architectural or implementation questions here as they
arise.

## Milestones

1. Repository baseline and dev environment documentation — **complete**
2. PE specification (`docs/specs/PE_SPEC.md`) — **complete** (draft, reviewed)
3. Numerical format decision — **complete** (2026-08-10)
4. Accumulator width, overflow, result-read decisions — **complete** (2026-08-10)
5. Reset semantics, pipeline architecture decisions — **complete** (2026-08-10)
6. **All six PE-blocking decisions resolved.** RTL entry criteria satisfied.
7. V1 PE RTL implementation (`rtl/common/pe.sv`) — **complete**
8. V1 PE unit testbench (`sim/tb_pe.sv`) — **complete** (55/55 PASS in simulation)
9. V1 systolic array specification (`docs/specs/SYSTOLIC_ARRAY_SPEC.md`) and
   dataflow decision (Decision 7) — **complete** (2026-08-17)
10. V1 array scheduling decisions (Decision 8) — **complete** (2026-08-17);
    `systolic_array.sv` unblocked
11. Systolic array RTL (`rtl/common/systolic_array.sv`) — **complete**
12. V1 systolic-array testbench (`sim/tb_systolic_array.sv`) — **complete**
    (379/379 PASS in Vivado ML 2023.1)
13. Input-feed / line-buffer module (separate spec + RTL) — **complete**
    (`rtl/common/input_feed.sv` + `sim/tb_input_feed.sv` +
    `docs/specs/INPUT_FEED_SPEC.md`; unblocked by Decision 9)
14. Synthesis/DSP48E2 inference — **complete** (1 DSP/PE, 64/array); full
    array-level integration (controller/BRAM/input-feed) — **pending**
15. V1 convolution mapping decision (row-decomposed 5-pass) — **complete**
    (2026-08-17); supersedes the withdrawn single-pass 2-D schedule
16. Team B V2 extensions (reconfigurable dataflow: PE-v2 + systolic-array-v2) —
    **complete** (335/335 PASS, 64 DSP48E2, 200 MHz WNS +2.861 ns); Team A V2
    sparsity extension — **pending**
17. V2 controller/input-feed (realizes the §9 WS schedule) — **pending**
    (unblocked by Decision 13)

## Next Planned Work

1. ~~**Decision 1: numerical format.**~~ **COMPLETE (2026-08-10).**
2. ~~**Decisions 2–4: accumulator width, overflow, result-read.**~~ **COMPLETE (2026-08-10).**
3. ~~**Decisions 5–6: reset semantics, pipeline architecture.**~~ **COMPLETE (2026-08-10).**
4. ~~**V1 PE RTL implementation.**~~ **COMPLETE** — `rtl/common/pe.sv` implemented.
5. ~~**V1 PE unit testbench.**~~ **COMPLETE** — `sim/tb_pe.sv`; Vivado 2023.1
   simulation passes 55/55.
6. ~~**V1 systolic array specification + dataflow decision.**~~ **COMPLETE** —
   `docs/specs/SYSTOLIC_ARRAY_SPEC.md` (draft); Decision 7 recorded (2026-08-17).
7. ~~**Resolve the array's scheduling decisions.**~~ **COMPLETE** — Decision 8
   (padding, skew, drain, tap order, peak-vs-sustained) recorded (2026-08-17).
8. ~~**Systolic array implementation + array-level verification.**~~ **COMPLETE** —
   `rtl/common/systolic_array.sv` + `sim/tb_systolic_array.sv`; Vivado 2023.1
   simulation passes 379/379.
9. ~~**Input-feed / line-buffer module specification and RTL.**~~ **COMPLETE** —
   `rtl/common/input_feed.sv` + `sim/tb_input_feed.sv` +
   `docs/specs/INPUT_FEED_SPEC.md` (spec unblocked by Decision 9).
10. ~~**Vivado synthesis and DSP48E2 inference check on the target device.**~~
    **COMPLETE** — 1 DSP48E2/PE, 64/array (`use_dsp` attribute required for 8×8).
11. ~~**V1 convolution mapping (row-decomposed 5-pass).**~~ **COMPLETE** —
    Decision 9 recorded (2026-08-17); supersedes the withdrawn single-pass 2-D
    schedule.
12. **V2 controller/input-feed internals** that realize the §9 WS schedule
    (`docs/specs/SYSTOLIC_ARRAY_V2_SPEC.md` §9) — unblocked by Decision 13
    (2026-08-20).

## Research Discipline

- Distinguish roadmap requirements from external research facts.
- Distinguish research facts from engineering recommendations.
- Do not allow common CNN accelerator practice to become a project
  requirement without an explicit team decision.
- Do not over-engineer infrastructure before it is needed; prioritise
  accelerator architecture and RTL development.
