ShashankT-ECE/cnn-accelerator/v2/tb/README.md

# tb — Self-checking xsim testbenches, one per RTL module; each prints PASS/FAIL and exits nonzero on failure.
