ShashankT-ECE/cnn-accelerator/v2/paper/PAPER_PLAN.md

# ROCS 2026 Paper Plan — KV260 CNN Accelerator

Sep 30, 2026 · @shashank

> Converted from the PDF "ROCS 2026 Paper Plan — KV260 CNN Accelerator" (10 pages,
> downloaded 2026-10-02) to Markdown. The text is unchanged except for layout.
> This file is the source of truth for structure, thesis, page budgets, writing
> rules and final numbers.
>
> **Corrections (2026-10-02, checked against the results CSVs):** requantization is
> "verified bit-exact on every non-saturating input" (139.6M values exhaustive, 486.6M
> in total with the saturation boundaries and samples; `requant_equivalence.csv`), not
> "proven over all ~475M reachable inputs" (475M was the CIFAR-10 r1 count); 2 of 354
> channels needed a 1-LSB adjustment of m (near-ties), not 3 (DECISIONS D1 outcome);
> best-CPU energy CIFAR-10 0.895 mJ (`tab_b1_power`), not 0.893; 16.5k LUTs (16,538);
> the limits audit is 49 boundary cases (`limits_rtl.csv`). The text below is updated.

## Submission facts

We submit a short paper to ROCS 2026, due October 9, 2026 AoE (about 5:30 PM IST on
October 10). CFP

| Item | Detail |
|---|---|
| Venue | ROCS 2026 workshop at IEEE HiPC 2026, Bengaluru, Dec 16 |
| Track | Short paper (fallback: 2-page poster abstract) |
| Length | 4 pages excluding references; figures count toward the 4 pages |
| Format | IEEE conference template (IEEEtran), two-column, 10 pt |
| Review | Single-blind, at least 3 reviewers. Author names stay on the paper |
| Submit | Linklings, select the ROCS track |
| Notification | November 6, 2026 |
| Camera-ready | November 13, 2026 (firm) |
| If accepted | One author presents in person; one full HiPC 2026 registration required |
| Publication | HiPC Workshops proceedings and IEEE Xplore. Authors can opt out at camera-ready and keep the right to publish an extended version elsewhere |

The CFP themes that fit us are "AI/ML on FPGAs: CNNs" and "case studies, reproducibility
and lessons learned".

## Thesis and title

**Thesis:** a small INT8 accelerator on the KV260 whose performance is exactly predictable.
Its analytical cycle model, its RTL and the real board agree to the cycle on every layer, and
its outputs are bit-exact against the reference.

We do not compete on raw throughput. Our strengths are exactness, determinism, honest
measurement and reproducibility. Every section should support that.

**Comparison position (final):** against the AMD DPU we are 1.5× faster on LeNet-5 at half
its energy per image, and 1.6× slower on CIFAR-10 at equal energy, while the loaded design
adds about 0.23 W at idle against the DPU's 1.15 W. Against the best CPU (ONNX Runtime
INT8, 4 threads) we are 2.1–3.1× faster and use 5.5–7× less energy. Never claim to beat the
DPU overall; lead with exactness, zero-spread compute latency and energy, and state the
DPU's CIFAR-10 latency win plainly. End-to-end spread comes from the Python host, so
the determinism claim applies to accelerator compute only.

**Working titles (pick one):**

1. Predictable by Construction: A Cycle-Exact, Bit-Exact INT8 CNN Accelerator on the
   Kria KV260
2. When the Model Is the Hardware: Cycle-Exact Performance Prediction for an FPGA
   CNN Accelerator
3. From Analytical Model to Silicon: A Verified, Deterministic INT8 CNN Accelerator on
   the KV260

**Contributions** (these become the bullet list at the end of the introduction):

1. An 8×8 output-stationary INT8 accelerator on the KV260 with a requantization
   contract verified bit-exact on every non-saturating input (139.6M values exhaustive,
   486.6M in total).
2. An analytical cycle model, with constants fixed before the RTL was simulated, that
   predicts every layer's cycles exactly: on 20,000 test images, 286 random layer jobs, and
   the board.
3. A board evaluation on the same KV260: deterministic latency, SOM-rail energy, a
   7-point clock sweep, and comparison with the on-board ARM CPU and the AMD DPU.
4. A fully reproducible artifact: every reported number is generated by script from a
   tagged commit, with hashed logs.

## Draft abstract

About 180 words. Bracketed values come from the board; everything else is already
measured or verified.

> FPGA accelerator papers often report performance from models or simulation,
> leaving the gap to real hardware unquantified. We present an INT8 CNN accelerator
> for the AMD Kria KV260 whose performance is exactly predictable. An 8×8 output-
> stationary array of DSP48E2 slices runs LeNet-5 and a CIFAR-10 network entirely on
> chip at 250 MHz, using 80 DSPs and 16.5k LUTs. Its requantization is verified bit-exact
> against the floating-point reference on every non-saturating input. An analytical
> cycle model, fixed before RTL simulation, predicts per-layer cycle counts with zero
> error across 20,000 test images and 286 random layer configurations in RTL
> simulation, and [on the KV260 board]. Measured on the board, inference takes [X] µs
> for LeNet-5 and [Y] µs for CIFAR-10, with [zero] latency variation, at [Z] µJ per image
> of SOM-rail energy. It is [A]× faster than the on-board Cortex-A53 and [B] against the
> AMD DPU. All results are regenerated by script from a tagged commit.

Rules for the final version: replace every bracket with the measured value, and delete any
claim the board does not confirm.

## Structure and page budget

Eight sections in 4 pages, which is 8 columns. Six of the eight can be written now; only
Results and part of the Abstract need the board.

| # | Section | Columns | Figures / tables | Write now? |
|---|---|---|---|---|
| — | Abstract | 0.4 | — | Draft yes, final numbers after board |
| I | Introduction | 0.8 | — | Yes |
| II | Related work | 0.5 | — | Yes (needs literature search) |
| III | Architecture | 1.3 | Fig. 1 block diagram | Yes |
| IV | Cycle model | 0.6 | — | Yes |
| V | Verification methodology | 1.0 | Fig. 2 verification flow | Yes |
| VI | Experimental setup | 0.5 | Table I implementation | Yes |
| VII | Results | 2.4 | Fig. 3 agreement, Fig. 4 shapes, Table II results | After board |
| VIII | Conclusion and limitations | 0.4 | — | Mostly yes |
| | References | extra pages | — | Yes |

If we run over, cut in this order: Fig. 2, then Related work down to 0.3 columns, then the
clock sweep to one sentence.

## Section-by-section content

Each section lists what it must say. "Now" means writable today from laptop results;
"Board" means it waits for measurements.

### I. Introduction (Now)

1. Problem: FPGA CNN accelerator papers often report modeled or simulated
   performance; the gap to real hardware is rarely quantified.
2. Why it matters: predictable latency matters for embedded and real-time use; a model
   you can trust enables design-space exploration without building every design.
3. Our approach: build the model first, fix its constants before simulation, then hold RTL
   and board to it cycle for cycle.
4. Contributions list (from the Thesis section).
5. One sentence on scope: small networks by design; the claim is exactness, not peak
   throughput.

### II. Related work (Now, needs literature search)

1. FPGA CNN accelerators (output-stationary and systolic designs, small-network edge
   accelerators).
2. Analytical performance models for accelerators and how closely they have matched
   hardware.
3. Vendor IP: the AMD DPU on Kria.
4. Verification and reproducibility practice in FPGA research.

End with one sentence on the gap we fill: few works show model, RTL and board agreeing
exactly. Do not cite anything we haven't read.

### III. Architecture (Now)

1. Numeric contract: signed INT8, zero-point 0, per-tensor activation scales, per-output-
   channel weight scales, INT32 accumulation. Requantization = (acc + q_bias) × m,
   round-half-to-even shift by s, clip, ReLU. Final layer exports raw INT32 logits.
2. Datapath: 8×8 output-stationary outer-product array; rows = 8 consecutive output x
   positions, columns = 8 output channels; each PE is one DSP48E2. Double-buffered
   drain overlapped with the next tile. 8 requant lanes, fused 2×2 max-pool.
3. Memory: everything on-chip in BRAM, no DRAM traffic during inference. Ping-pong
   activation buffers banked by x mod 8 with a kx rotator for conflict-free reads; all
   weights resident.
4. Control: counter-only address generation (no multipliers), token pipeline, descriptor
   sequencer for up to 8 layers per start, pipelined config checker.
5. Interface: AXI-Lite CSR with cycle, MAC-active and stall counters, per-layer cycle
   registers, logits, BUILD_ID; loaded as a PYNQ overlay.
6. Supported shapes: VALID convolution, stride 1, kernel width ≤ 9 (host-enforced;
   verified at the boundary in RTL simulation).

### IV. Cycle model (Now)

1. Tiling order and tile count: T = ceil(OC/8) × OH × ceil(OW/8).
2. Per-layer cycles = T × K + C_PIPE (29), where K = IC × KH × KW; plus C_START (3) per
   job.
3. Constants were committed before the first RTL simulation.
4. Utilization analysis: 39.6% (LeNet) and 67.3% (CIFAR), lost mostly to partial 8-wide
   tiles; layers with a 1×1 output capped at 12.5%, 10-class final layers at 7.8%. This is the
   known output-stationary limit.
5. Ablation (model): a per-kernel-row schedule would take 1.83× (LeNet) and 2.16×
   (CIFAR) the cycles.

### V. Verification methodology (Now)

1. Requantization verified bit-exact on every non-saturating input (139.6M values
   exhaustive, 486.6M in total); 2 of 354 channels needed a 1-LSB adjustment of m
   (near-ties of the rounded multiplier).
2. Golden model matches the legacy reference on all 10k images of both networks.
3. Full-dataset RTL simulation: 20,000 images bit-exact and cycle-exact, Verilator cross-
   checked against xsim.
4. Random-shape validation: 300 seeded jobs in 13 categories; all 286 valid jobs bit-exact
   and cycle-exact; all 14 invalid jobs correctly refused.
5. Robustness: 100 back-to-back AXI jobs including a refused job and a mid-job soft reset;
   post-synthesis netlist simulation.
6. What verification found: random shapes revealed an unchecked kernel-width limit,
   now host-enforced. A follow-up audit boundary-tested the descriptor fields in 49 cases
   in two simulators and added host checks wherever the hardware checker has a gap.
   One or two sentences; it shows the method works.
7. Provenance: every number is script-generated from a clean commit with bitstream
   SHA256 and BUILD_ID; logs archived with hashes.

### VI. Experimental setup (Now)

1. Board: KV260 (K26 SOM), Kria Ubuntu 22.04, Kria-PYNQ. Clock: 250 MHz, set from the
   PS PLL and verified by read-back; all µs values use the read-back clock. The design also
   closes timing at 300 MHz, but the KV260's default PS PLL (999.99 MHz) cannot divide
   to it.
2. Implementation table (Table I).
3. Protocol: CPU governor fixed, cores pinned, warm-up discarded, ≥100 repeats, median
   with 95% CI, interleaved conditions.
4. Power: SOM-rail INA260 (VCC_SOM); idle, accelerator, control and CPU phases; energy
   = ΔP × time.
5. Baselines: Cortex-A53 (numpy INT8/FP32, ONNX Runtime FP32/INT8, 1 and 4 threads);
   AMD DPU with the prebuilt pynq_dpu 2.5 overlay.

### VII. Results (Board)

1. Three-way agreement: per-layer cycles model = RTL = board; spread across 10k images
   (Fig. 3).
2. Correctness: 0 logit mismatches on 10k images per net; accuracy equals golden.
3. Latency and throughput: compute-only and end-to-end p50/p95/p99; images/s.
4. Energy: µJ per image, GOPS/W, SOM-rail.
5. Comparison: CPU and DPU on the same board (Table II). Lead with determinism and
   latency, report throughput honestly.
6. Generality: random-shape predicted vs measured cycles (Fig. 4).
7. Clock sweep: cycles constant, latency ∝ 1/f, static vs dynamic power fit. One or two
   sentences.

### VIII. Conclusion and limitations (Mostly now)

1. Restate the claim with the headline numbers.
2. Limitations: small networks; VALID, stride 1 only; single 8×8 array; SOM-rail power
   includes the CPU driving the accelerator.
3. Future work: padding and stride, 16×16 array, larger networks.

## Figures and tables

Four pages hold about four figures and two tables. Data figures and tables come from the
repo's paper pipeline (v2/paper/); only Fig. 1 and Fig. 2 are drawn by hand.

| ID | Content | Source | Status |
|---|---|---|---|
| Fig. 1 | Architecture block diagram: PS, AXI, CSR, buffers, 8×8 array, requant, pool | Draw by hand (draw.io or TikZ) | Start now |
| Fig. 2 | Verification and provenance flow: model → RTL → board, with checks at each step | Draw by hand | Start now; first to cut |
| Fig. 3 | Per-layer cycles, model vs RTL vs board, both nets (the key figure) | Pipeline (A3) | Model and RTL done; board pending |
| Fig. 4 | Predicted vs measured cycles for random shapes (y = x) | Pipeline (fig_shapes_cycles) | RTL done; board pending |
| Table I | Implementation: clock, WNS/WHS, LUT, FF, DSP, BRAM | Pipeline (T1) | Done |
| Table II | Results vs baselines: accuracy, latency p50/p99, throughput, energy per image, GOPS/W for accelerator, A53 and DPU | Pipeline | Board pending |

Optional if space allows: the clock-sweep plot, as a small inset or one sentence.

**Revision 2026-10-02 (fit to 4 pages):** Fig. 2 is dropped (its content is two sentences
at the start of Section V), so the data figures are numbered Fig. 2 (per-layer cycles,
`fig_a3_cycles`) and Fig. 3 (random shapes, `fig_shapes_cycles`). Fig. 1 is TikZ
(`tex/sections/fig_arch.tex`). Table I = `tab_impl_compact` (250 MHz build only, 300 MHz
as a note). Table II = `tab_compare` (ours / DPU / best CPU per net: e2e p50, SOM-rail
energy per image, speedup vs the best CPU baseline). GOPS/W is not reported. Section IV
defines one utilization metric (PE utilization = useful MACs / (64 × TOTAL_CYC)).

## Final numbers (frozen Oct 2)

Experiments are frozen at tag v2-paper-freeze. All board numbers are measured on the
KV260 at 250 MHz; power is SOM-rail (INA260). Final paper values come from the pipeline
(median across 3 sessions); these are for writing.

| Quantity | LeNet-5 | CIFAR-10 |
|---|---|---|
| Accuracy, model = board (10k images, bit-exact) | 98.79% | 78.52% |
| Cycles, model = RTL = board (20k images, zero spread) | 16,436 | 104,247 |
| Accelerator compute latency | 65.7 µs | 417.0 µs |
| End-to-end latency, fast host path (median) | 224.5 µs | 578.5 µs |
| Best CPU, ONNX Runtime INT8 ×4 (median) | 695 µs | 1228 µs |
| Speedup vs best CPU, end-to-end | 3.1× | 2.1× |
| DPU end-to-end (median) | 346 µs | 353 µs |
| Accelerator vs DPU, end-to-end | 1.5× faster | 1.6× slower |
| Energy per image: ours / DPU / best CPU | 0.065 / 0.124 / 0.454 mJ | 0.161 / 0.166 / 0.895 mJ |
| Throughput (compute) | 15,210 img/s, 12.7 GOPS | 2,398 img/s, 21.6 GOPS |

| Robustness and repeatability | Value |
|---|---|
| Random layer shapes | 286/286 exact on the board; 14/14 invalid jobs refused |
| Soak test | 3.65M inferences in 30 min, 0 errors, 37.7 °C max |
| Cycles across 7 clocks | Identical at every clock |
| Repeatability, 3 sessions | End-to-end latency CV 0.3–0.5%; CIFAR-10 energy CV 0.4%; LeNet-5 energy CV 3% |

| Implementation and power | Value |
|---|---|
| Resources (250 MHz build) | 16,538 LUT, 22,985 FF, 80 DSP, 50 RAMB36 + 1 RAMB18 |
| Timing | WNS +0.207 ns at 250 MHz; also closes at 300 MHz (+0.122 ns, post-implementation only) |
| Idle power: no overlay / ours / DPU | 3.21 / 3.44 / 4.36 W |
| Power vs clock | 1.10 mW/MHz, R² 0.996 over 7 clocks (two clean sweeps differed by 8–22%) |

Other verified facts: peak compute 32 GOPS; requantization verified bit-exact on every
non-saturating input (139.6M exhaustive, 486.6M total);
all bitstreams built from RTL commit fd880d4.

## Writing rules

Reviewers reject papers for overclaiming more often than for modest results. These rules
keep every sentence defensible.

1. Label every number by origin: model, RTL simulation, post-implementation, or
   measured on the KV260.
2. Say "SOM-rail power (INA260)", never "accelerator power" or "FPGA power".
3. Say "projected" for anything model-only, such as the 16×16 array.
4. No number typed by hand: tables and figures come only from the pipeline.
5. No claim of "state of the art" or "fastest". Compare fairly and report where the DPU
   wins.
6. Every citation must be a paper someone on the team has actually read.
7. Report limitations in the paper itself; reviewers trust papers that state them.
8. Use LaTeX with IEEEtran (Overleaf works); keep the .tex in the repo under v2/paper/.

## Writing order and schedule

Write the board-independent sections first and submit on October 8, keeping October 9
as buffer. Board sessions run whenever access arrives; Results waits only for them.

- Sep 30 – Oct 1: pick the title, set up the IEEEtran template, draft Fig. 1, write Sections III
  (Architecture) and IV (Cycle model)
- Oct 2 – 3: write Section V (Verification) and VI (Setup); literature search and Section II
  (Related work)
- Oct 3: write the Introduction and Conclusion, now that the body exists
- As soon as the board is ready: Sessions 1–3 (board data must be in by Oct 5)
- Oct 5 – 6: write Section VII (Results) from the pipeline; fill the abstract numbers
- Oct 7: full draft; cut to exactly 4 pages
- Oct 8: proofread, one teammate reads it cold, submit on Linklings (ROCS track)
- Oct 9: buffer only

If board data is not in by Oct 5, decide that day between a short paper with partial board
results and the 2-page poster-abstract track.
