ShashankT-ECE/cnn-accelerator/v2/paper/tex/sections/conclusion.tex

% Section VIII -- Conclusion and limitations (target 120 words).
\section{Conclusion and Limitations}\label{sec:conclusion}
A small INT8 accelerator can be predictable by construction: on the KV260
our design matches its cycle model on every layer, in RTL simulation and on
the board, with bit-exact logits and compute latency that never varied by a
cycle. It beats the best CPU baseline on both networks and the DPU on
LeNet-5, loses to the DPU on CIFAR-10, and per image uses about half the
DPU's energy on LeNet-5, a comparable amount on CIFAR-10 and 5.5--7$\times$
less than the CPU.

The limits are clear. The networks are small; only VALID, stride-1
convolutions with kernel width up to 9 are supported; PE utilization is
39.6\,\% on LeNet-5; SOM-rail power includes the host CPU; and end-to-end
latency depends on a Python host. Future work adds padding and stride, a
larger array (a 16$\times$16 array is so far only projected by the model)
and larger networks.
% src: utilization_model.csv (LeNet-5 util_total 0.395968); projection_16x16.csv (projected, model only)
