ShashankT-ECE/cnn-accelerator/v2/paper/tex/sections/related.tex

% Section II -- Related work (target 120 words).
% Writing rule 6: every cited paper must be read by a team member before submission
% (status in v2/paper/RELATED_NOTES.md -- none ticked yet).
\section{Related Work}\label{sec:related}
Dataflow taxonomies trade data reuse against utilization~\cite{sze2017efficient}.
FPGA designs choose their tiling from roofline or loop-optimization
models~\cite{zhang2015optimizing,ma2018optimizing}, stream binarized networks
through per-layer pipelines~\cite{umuroglu2017finn}, or run compiled
instructions on embedded Zynq devices~\cite{guo2018angeleye}; our numerics
follow integer-only quantization~\cite{jacob2018quantization}.
Timeloop~\cite{parashar2019timeloop}, MAESTRO~\cite{kwon2019maestro} and
SCALE-Sim~\cite{samajdar2020scalesim} model performance across large design
spaces, and Gemmini~\cite{genc2021gemmini} shows that system effects outside the
accelerator change measured results, as our host-side latency also shows. The AMD DPU~\cite{amd_pg338} is the standard CNN engine on
Kria devices~\cite{costa2026kv260}; we use it as a same-board baseline. We are
not aware of work in which an analytical model, RTL simulation and board
measurements agree exactly on every layer.
