ShashankT-ECE/cnn-accelerator/v2/model/README.md

# model — Python golden model, integer-requant equivalence checks, cycle model and vector generation for V2 (runs in the repo .venv).
