ShashankT-ECE/cnn-accelerator/v2/scripts/README.md

# scripts — Build, simulation and results-collection scripts for V2 (simulations run in v2/build/sim/<tb_name>/).
