ShashankT-ECE/cnn-accelerator/v2/vivado/README.md

# vivado — Vivado 2023.1 Tcl, XDC and block-design sources for synthesis, implementation and bitstream generation.
