ShashankT-ECE/cnn-accelerator/v2/docs/LIMITS.md

# V2 descriptor limits: hardware vs. config checker vs. host

**Status:** audit of every descriptor field (2026-09-30). RTL is frozen; nothing here changes it.
Descriptor layout, checker rules 1–27 / 32 and the host-responsibility list: [FORMATS.md §5](FORMATS.md#5-layer-descriptor-16-x-32-bit-words-per-layer).
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
