ShashankT-ECE/cnn-accelerator/data/benchmark/sparsity_accounting.csv

index | label | total_mac_opportunities | zero_activation_macs | executed_macs | activation_zero_fraction_pct | skippable_positions | skippable_group_fraction_pct | skippable_macs_coarse | skippable_mac_fraction_pct | ws_dense_cycles | ws_sparse_cycles | measured_cycle_reduction_pct | measured_speedup | fine_grained_max_speedup
0 | 7 | 156800 | 133960 | 22840 | 85.43 | 60 | 53.57 | 73600 | 46.94 | 38528 | 18368 | 52.33 | 2.098 | 6.865
1 | 2 | 156800 | 123920 | 32880 | 79.03 | 37 | 33.04 | 42400 | 27.04 | 38528 | 26096 | 32.27 | 1.476 | 4.769
2 | 1 | 156800 | 144000 | 12800 | 91.84 | 66 | 58.93 | 83200 | 53.06 | 38528 | 16352 | 57.56 | 2.356 | 12.25
3 | 0 | 156800 | 118200 | 38600 | 75.38 | 36 | 32.14 | 43200 | 27.55 | 38528 | 26432 | 31.4 | 1.458 | 4.062
4 | 4 | 156800 | 132800 | 24000 | 84.69 | 48 | 42.86 | 54400 | 34.69 | 38528 | 22400 | 41.86 | 1.72 | 6.533
5 | 1 | 156800 | 140600 | 16200 | 89.67 | 67 | 59.82 | 84800 | 54.08 | 38528 | 16016 | 58.43 | 2.406 | 9.679
6 | 4 | 156800 | 129800 | 27000 | 82.78 | 42 | 37.5 | 51200 | 32.65 | 38528 | 24416 | 36.63 | 1.578 | 5.807
7 | 9 | 156800 | 131000 | 25800 | 83.55 | 48 | 42.86 | 61600 | 39.29 | 38528 | 22400 | 41.86 | 1.72 | 6.078
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
