ShashankT-ECE/cnn-accelerator/v2/results/README.md

# results — Script-generated results CSVs with metadata (raw/ is gitignored); no hand-typed numbers.
