ShashankT-ECE/cnn-accelerator/v2/results/board_20260930_gos300_at_200mhz/hw_fclk_cal_s1.csv

timestamp | git_commit | git_dirty | vivado_version | bitstream_sha256 | board_id | net | layer | clock_mhz | source | duration_s | num_inferences | build_id_hw | board_hostname | clock_source | scripts_commit | data_manifest_sha256 | data_git_commit | data_git_dirty | backend | session_index | paper_grade | env_step | cpu_governor | cpu_freq_khz | cpu_affinity | die_temp_start_c | env_note | f_req_mhz | f_readback_mhz | f_meas_mhz | f_meas_ci_lo_mhz | f_meas_ci_hi_mhz | f_meas_source | estimator_mhz | f_simple_mhz | ppm_vs_readback | readback_in_ci | method | clock_ts | net_a | net_b | cycles_a | cycles_b | jobs_a | jobs_b | median_dt_a_ns | median_dt_b_ns | intercept_a_ns | intercept_b_ns | seconds | rounds | warmup_per_block | block_order | seed | n_boot | repeats_ok | cycles_constant | host_path
2026-09-30T15:38:48+00:00 | 11aa4f0561d40b905c27206bc0d62eaff2373906 | False | 2023.1 | 2d40e2c8de2fb0183fffbccec529c92da67e4d964c05505d4178c4752d4ffeb5 | ZynqMP KV260 revB machine-id:a435d1c5 | lenet5+cifar10 | all | 199.998000 | hw | 12.229 | 12365 | fd880d43 | kria | pynq Clocks.fclk0_mhz readback | 11aa4f0561d40b905c27206bc0d62eaff2373906 |  |  |  | pynq | 1 | True | s1.fcal | performance | 1333333 | 3 | 35.702 | paper-grade environment | 300 | 199.998000 | 201.992064 | 201.954899 | 202.025059 | calibration (differential, CLOCK_MONOTONIC_RAW) | 201.992064 | 191.847048 | 9970.4 | False | differential: f = (C_B - C_A) / (median dt_B - median dt_A); dt = CLOCK_MONOTONIC_RAW start->done; 95% CI percentile bootstrap | CLOCK_MONOTONIC_RAW | lenet5 | cifar10 | 16436.0 | 104247.0 | 9518 | 2847 | 108661.0 | 543386.0 | 27291.5 | 27291.5 | 8.0 | 2 | 5 | lenet5 cifar10 lenet5 cifar10 | 953258510 | 2000 | True | True | safe
