ShashankT-ECE/cnn-accelerator/v2/results/board_20260930_s1_gos250_eb5fca3/hw_fclk_cal_s1.csv

timestamp | git_commit | git_dirty | vivado_version | bitstream_sha256 | board_id | net | layer | clock_mhz | source | duration_s | num_inferences | build_id_hw | board_hostname | clock_source | scripts_commit | data_manifest_sha256 | data_git_commit | data_git_dirty | backend | session_index | paper_grade | env_step | cpu_governor | cpu_freq_khz | cpu_affinity | die_temp_start_c | env_note | f_req_mhz | f_readback_mhz | f_meas_mhz | f_meas_ci_lo_mhz | f_meas_ci_hi_mhz | f_meas_source | estimator_mhz | f_fold_min_mhz | f_fold_max_mhz | n_folds | f_median_est_mhz | f_simple_mhz | ppm_vs_readback | rel_diff_pct | agree_tol_pct | fcal_flag | readback_in_ci | method | clock_ts | net_a | net_b | cycles_a | cycles_b | jobs_a | jobs_b | min_dt_a_ns | min_dt_b_ns | median_dt_a_ns | median_dt_b_ns | intercept_a_ns | intercept_b_ns | poll_period_ns
2026-09-30T16:00:36+00:00 | eb5fca3e4831a06b887182c32b8355c957e564f0 | False | 2023.1 | 7b2dac6026acf6ae9e6d87f80a457fb07b6e56c167dd2a168593b2105c9e130e | ZynqMP KV260 revB machine-id:a435d1c5 | lenet5+cifar10 | all | 249.997500 | hw | 9.512 | 12222 | fd880d43 | kria | pynq Clocks.fclk0_mhz readback | eb5fca3e4831a06b887182c32b8355c957e564f0 |  |  |  | pynq | 1 | True | s1.fcal | performance | 1333333 | 3 | 35.314 | paper-grade environment | 250 | 249.997500 | 249.886171 | 249.832704 | 249.940378 | cross-check (differential lower envelope, CLOCK_MONOTONIC_RAW) | 249.886171 | 249.800156 | 249.979361 | 8 | 250.503512 | 239.582735 | -445.3 | -0.0445 | 0.100 | False | False | differential lower envelope: f = (C_B - C_A) / (min dt_B - min dt_A); dt = CLOCK_MONOTONIC_RAW start->done, poll phase dithered over 2 poll periods; 95% t-interval over interleaved folds; cross-check only (clock of record = PLL read-back) | CLOCK_MONOTONIC_RAW | lenet5 | cifar10 | 16436.0 | 104247.0 | 9210 | 3012 | 80220.0 | 431624.0 | 84581.0 | 435119.0 | 14446.1 | 14446.1 | 6391.5
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
