ShashankT-ECE/cnn-accelerator/data/benchmark/figures/fig1_os_vs_ws_cycles.png

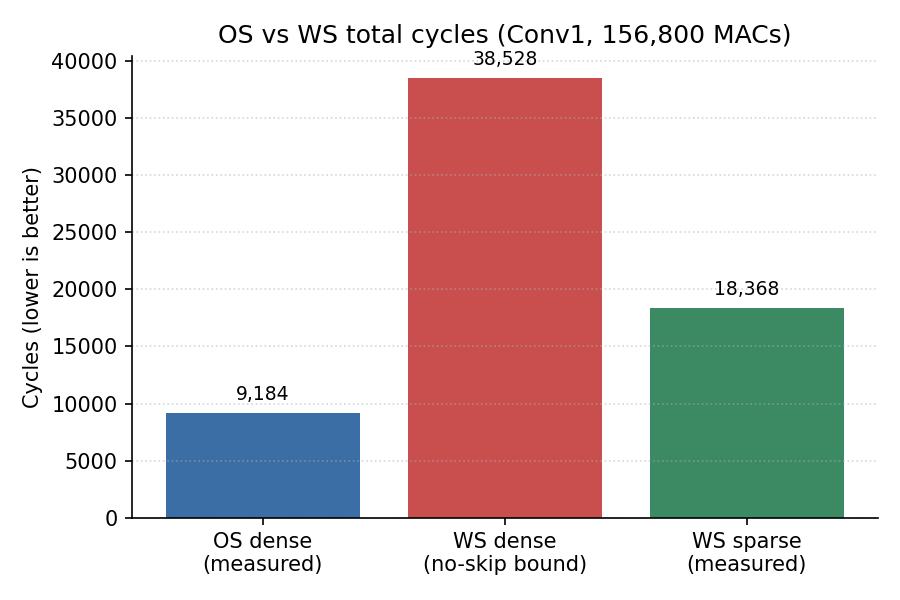
data/benchmark/figures/fig1_os_vs_ws_cycles.png
