ShashankT-ECE/cnn-accelerator/data/benchmark/figures/fig2_dense_vs_sparse.png

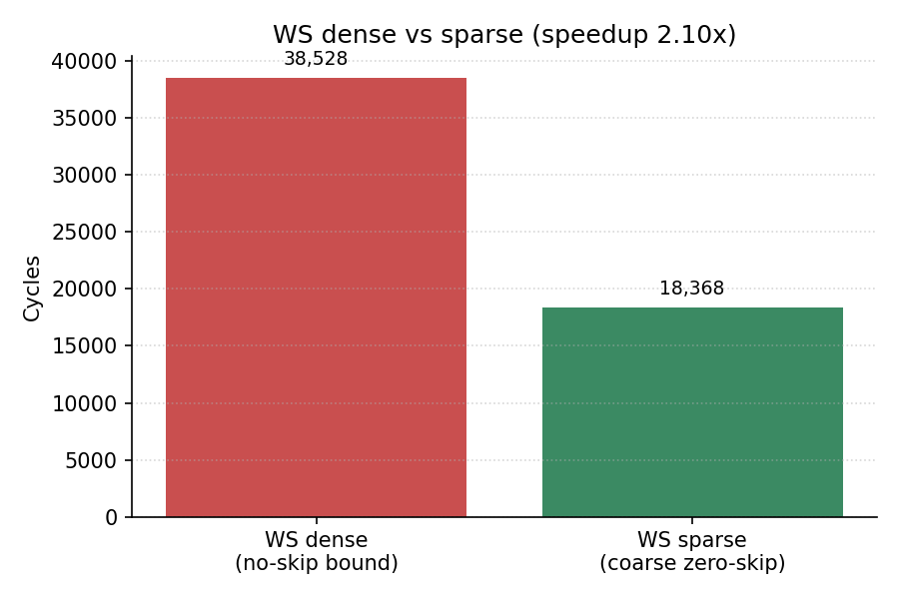
data/benchmark/figures/fig2_dense_vs_sparse.png
