ShashankT-ECE/cnn-accelerator/data/benchmark/figures/fig3_sparsity_accounting.png

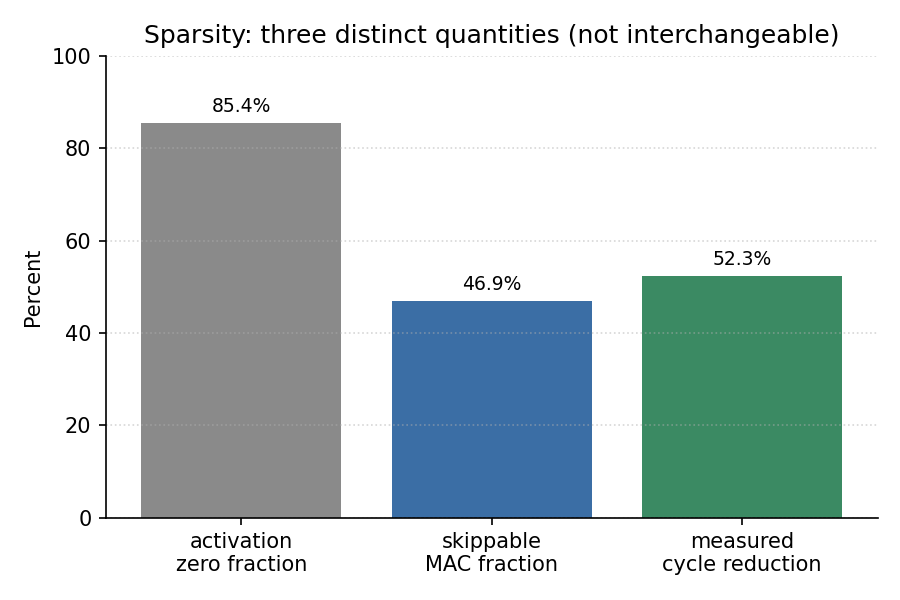
data/benchmark/figures/fig3_sparsity_accounting.png
