ShashankT-ECE/cnn-accelerator/data/benchmark/figures/fig4_resource_utilization.png

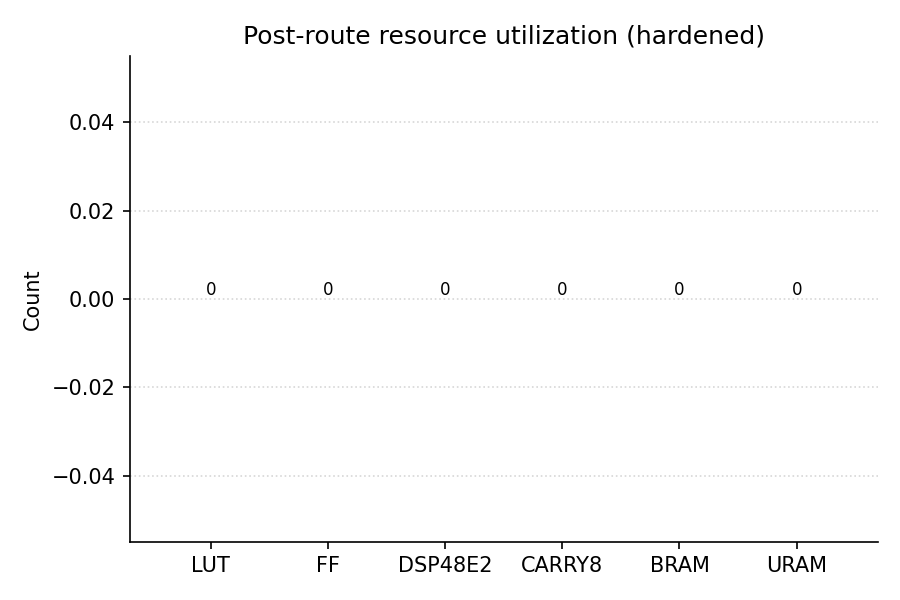
data/benchmark/figures/fig4_resource_utilization.png
