ShashankT-ECE/cnn-accelerator/data/benchmark/figures/fig5_reconfig_overhead.png

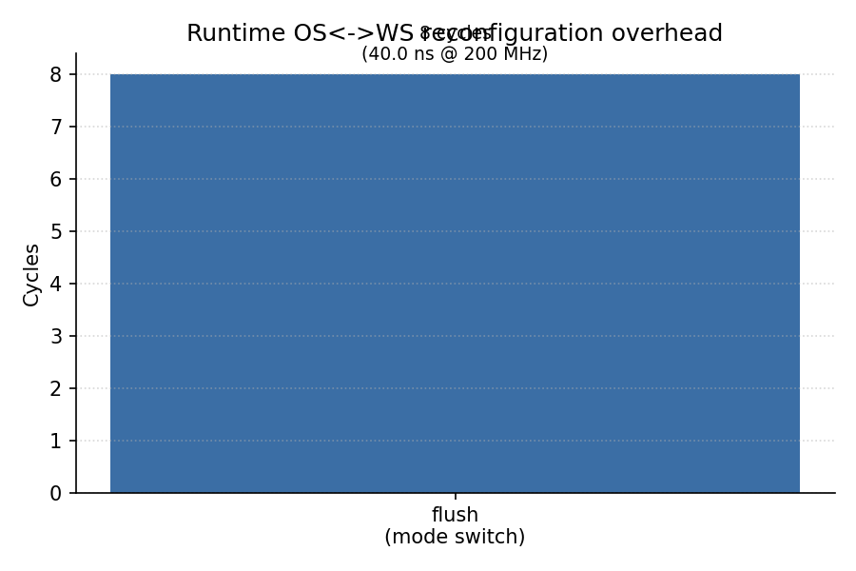
data/benchmark/figures/fig5_reconfig_overhead.png
