ShashankT-ECE/cnn-accelerator/data/benchmark/figures/fig6_multi_image_sparsity.png

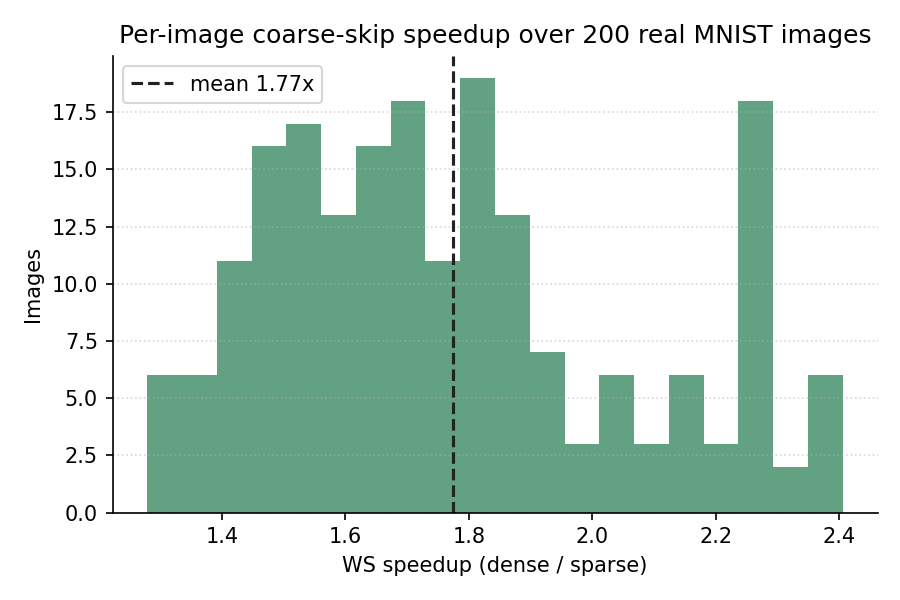
data/benchmark/figures/fig6_multi_image_sparsity.png
