ShashankT-ECE/cnn-accelerator/(commit log)

2026-08-21 feat: Phase 2 hardened reconfigurable-dataflow accelerator
    Runtime OS/WS reconfiguration on the frozen V2 systolic array with SAME
    padding, OC=8, and coarse zero-group skip, hardened for paper-readiness
    before KV260 integration.
    - rtl/common/cnn_accelerator_v2.sv: dual-mode controller; OS 9,184 / WS 18,368
    cycles (bit-exact vs golden); 8-cycle runtime flush (OS->WS->OS, WS->OS->WS
    verified, no reset); exact MAC counters 156,800 / 22,840 / 133,960.
    - Timing hardened WNS +0.030 -> +0.189 ns @ 200 MHz (~208 MHz max): register
    accum_clear/weight_load at the array boundary, pipeline MAC/cycle counters,
    shift-expand result_base (removes 3 controller DSPs), max_fanout on hot nets.
    Resour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
    [benchmark_matrix.csv, sparsity_accounting.csv]
2026-09-24 snapshot: preserve pre-V2 working state (Phase 3, CIFAR, docs, sparsity_disable)
    [benchmark_matrix.csv]
2026-09-24 V2 step 2.1: freeze CIFAR INT8, accuracies of record, requant equivalence (B=32)
    [final_layer_check.csv, reference_accuracy.csv, requant_equivalence.csv]
2026-09-24 V2 step 2.1b: CIFAR retrain r2 (not yet adopted)
    Same architecture (legacy Cifar10Net, no BN), legacy preprocessing and INT8
    pipeline. Crop+flip, SGD nesterov, wd 5e-4, cosine from 0.05, bs 128, 60 epochs,
    epoch chosen on val train[45000:50000] only; test evaluated once at the end.
    - v2/model/retrain/: training script, r2 FP32 checkpoint (+sha256, meta), check driver
    - freeze_cifar10_int8.py: --ckpt (refuses to overwrite cifar10_int8/)
    - final_layer.py: optional checkpoint override
    - frozen/cifar10_int8_r2/: quant params, manifest, SHA256SUMS, hw_requant (B=32)
    - results: retrain log, r2 accuracy, requant equivalence (B=32), final layer, summary
    Reference of record unchanged (frozen/cifar1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
    [cifar10_r2_accuracy.csv, cifar10_r2_summary.csv, cifar10_retrain_log.csv, final_layer_check_r2.csv, requant_equivalence_r2.csv]
2026-09-24 V2 step 2.2: regenerated results (clean)
    [cycle_model.csv, final_layer_check.csv, golden_crosscheck.csv, reference_accuracy.csv, requant_equivalence.csv]
2026-09-24 V2 step 2.1c: adopt CIFAR r2 reference
    - net_config: NET_CONFIGS["cifar10"] -> frozen/cifar10_int8_r2 (quant_params +
    hw_requant, r2 checkpoint); r1 kept as record-only NET_CONFIGS["cifar10_r1"]
    (not in NETS). Configs carry checkpoint and reference_version.
    - freeze script, final_layer, reference_accuracy follow NET_CONFIGS; the 2.1b
    --ckpt / ckpt overrides are kept. A registered param dir only accepts its own
    checkpoint. reference_accuracy.csv gains reference_version (lenet5_v1,
    cifar10_r1, cifar10_r2).
    - OC-2 (option 1): requant_check records s outside [1, 63] as infeasible for that
    B instead of stopping (cifar10 r2 needs s = 64 at B = 48); selected B = 32
    unchanged. gos_pack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
    [final_layer_check_r2.csv, requant_equivalence_r2.csv]
2026-09-24 V2 step 2.1c: regenerated results + vectors (r2, clean)
    [cifar10_r2_accuracy.csv, cifar10_r2_summary.csv, cycle_model.csv, final_layer_check.csv, golden_crosscheck.csv, reference_accuracy.csv, requant_equivalence.csv]
2026-09-24 V2 step 3: unit + OOC results (clean)
    [ooc_synth.csv, unit_tb.csv]
2026-09-24 V2 step 4: core RTL + network sim results (clean)
    [cifar10_r2_accuracy.csv, cifar10_r2_summary.csv, cycle_model.csv, final_layer_check.csv, golden_crosscheck.csv, impl_shell.csv, ooc_synth.csv, reference_accuracy.csv]
2026-09-24 V2 step 4.5: gos_top_wrapper, bd_shell clock/strategy params + static/power reports, build_gos.sh, back-to-back + netlist-sim TBs
    [rtl_checker.csv, rtl_cycles.csv, rtl_network.csv]
2026-09-24 V2 step 4.5: recovery after OOM freeze — netlist_collect, one Vivado job at a time (vivado_guard.sh: free -h, >= 8 GB, no concurrent Vivado), maxThreads 8, serialized runs
2026-09-25 V2 step 4.5: unit/top/back-to-back + core RTL sim results (clean @ 8050f44, C_START=3)
    [rtl_checker.csv, rtl_cycles.csv, rtl_network.csv, unit_tb.csv]
2026-09-25 V2 step 4.5: model results regenerated (clean @ e93db3d; cycle model C_START=3)
    [cifar10_r2_accuracy.csv, cifar10_r2_summary.csv, cycle_model.csv, final_layer_check.csv, golden_crosscheck.csv, reference_accuracy.csv, requant_equivalence.csv]
2026-09-25 V2 step 4.5: static checks — synth_scan.py (latch/multi-driven/undriven/removed logic, waivers), full synth logs (no message limit), check_timing loops in impl_collect
2026-09-25 V2 step 4.5: post-synthesis netlist sim results (clean @ fc13c08): tb_gos_top 1 LeNet + 1 CIFAR, back-to-back 3 jobs with soft_reset — all cycle- and logit-exact
    [rtl_netlist.csv]
2026-09-25 V2 step 4.5: 200 MHz full-design implementation results (build c88e71a0, clean; collected @ 0563651)
    [impl_gos.csv]
2026-09-25 V2 step 5 part 0/1: check_results per-row source identity (D16, final-freeze TODO); CSR DESC write stage for 250/300 MHz (D17, cycle-neutral; tb_gos_csr/top/backtoback PASS); top_paths.rpt
2026-09-25 V2 step 5 part 2: board software (gos_driver Pynq/Model backends, data package, A1-A4/B1-B3 experiment scripts, smoke test, run_all/deploy, tests) + CPU baselines (int8 ref, fp32 numpy, ORT fp32/int8)
2026-09-25 V2 step 5: deploy prints --max-fclk0 from the build's closed clock; test_shell limit message
2026-09-28 V2 steps 5/9/10: paper pipeline (v2/paper), model analyses (v2/analysis: utilization, V1-vs-V2 ablation, 16x16 projection), board session runner (resumable, budget, pre-flight), INA260 SOM-rail power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
2026-09-28 V2 step 5 results: regenerated model/RTL-sim CSVs (clean @ a660a04) + impl_gos 200/250/300 MHz (build fd880d43, collected clean @ fd880d4)
    [cifar10_r2_accuracy.csv, cifar10_r2_summary.csv, cycle_model.csv, final_layer_check.csv, golden_crosscheck.csv, impl_gos.csv, reference_accuracy.csv, requant_equivalence.csv]
2026-09-28 V2 step 9: final results freeze — all producers re-run clean @ 63261ad (model regen + analyses, unit/core/netlist sim, OOC, shell impl, verification_stats); impl_gos 200/250/300 MHz @ fd880d4 (source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
    [cifar10_r2_accuracy.csv, cifar10_r2_summary.csv, cycle_model.csv, final_layer_check.csv, golden_crosscheck.csv, impl_shell.csv, ooc_synth.csv, projection_16x16.csv]
2026-09-28 V2 step 9: docs — CLAUDE.md final implementation table + pending list, PROJECT_STATE V2 section, DECISIONS freeze TODO done
2026-09-28 V2 board: fast host path (vectorized MMIO, s1.fast bring-up gate, safe default), host-overhead mock benchmark, B1 control phase, energy two ways (E_sys, E_comp, duty cycle, dP-control), VCC_SOM cover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
2026-09-28 check_results: print per-CSV extra source paths
2026-09-28 V2 results: full-dataset RTL sim — 10,000/10,000 images per net bit-exact logits, pred match, cycle-exact (Verilator 5.028, cross-validated vs xsim; clean @ 55972c1); core CSVs regenerated with trimm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
    [rtl_checker.csv, rtl_cycles.csv, rtl_full10k.csv, rtl_network.csv, verification_stats.csv]
2026-09-28 V2 DPU baseline prep: Vitis AI 2.5.0 (matches pynq-dpu 2.5 prebuilt KV260 B4096 overlay, fingerprint 0x101000016010407), export/quantize/compile scripts, resumable image fetch, dpu_session.py (accura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
2026-09-29 V2 board rigor: external meter removed (INA260 only); pre-flight (performance governor, fixed freq, taskset pinning, apt/unattended-upgrades guard, AMS die temp, paper_grade flag); measured PL clock 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
    [aggregate_sessions.py, board_env.py, power_log.py, stats.py]
2026-09-29 V2 board experiments: 30-min soak (exp_soak), per-layer cycle spread over all images (exp_layer_spread), B2 cycle identity across clocks + P = P_static + k*f fit (exp_b2_clock, meter remnants removed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
2026-09-29 V2 results: DPU model-level accuracy (vai_q, Vitis AI 2.5.0; LeNet-5 / CIFAR-10 r2; xmodel sha256 + fingerprint) — clean @ ae67170
    [dpu_model_accuracy.csv]
2026-09-29 docs: CLAUDE.md + PROJECT_STATE after laptop-side reviewer-gap work (full-10k RTL sim, board rigor/experiments, DPU prep)
2026-09-29 docs: CLAUDE.md decision range D1–D18
2026-09-29 V2 results: full-10k RTL sim rerun @ 32738fe (10,000/10,000 per net bit- and cycle-exact, Verilator 5.028 cross-validated vs xsim) with compressed shard logs rtl_full10k_logs_32738feb85f3.tar.xz (sha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
    [rtl_full10k.csv]
2026-09-29 V2 A3-general RTL side: seeded random multi-layer shape set (seed 20260929, 300 jobs, 13 categories incl. 14 checker-refuse jobs), numpy loader v2/board/shapeset.py, Verilator harness with xsim cross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
2026-09-29 V2 A3-general board side: exp_shapes.py (bit-exact outputs under mask, refuse checks, cycles vs model and RTL-sim rows of the same shape set, 15-min hard cap, category-stratified order), session step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
2026-09-29 V2 results: A3-general random shapes RTL sim @ c2356f8 — 300 jobs (286 valid + 14 refuse), outputs bit-exact 286/286, cycles == model 286/286, refusals 14/14, Verilator 5.028 with 39-job xsim cross-c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
    [shapes_rtl.csv]
2026-09-29 V2 OC-3 + descriptor limits audit: KW <= 9 host contract (gos_pack.assert_host_limits, MAX_KW, test_kw_limit), host asserts for every limit the RTL checker does not enforce (assert_host_limits / asse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
2026-09-29 V2 results: descriptor limits boundary RTL sim @ 52cea7e — 49 cases (19 KW/KH + 30 field), Verilator 5.028 + xsim 2023.1 agree; KW <= 9 bit- and cycle-exact, KW >= 10 wrong outputs (OC-3); limits_rtl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
    [limits_rtl.csv]
2026-09-30 V2 results: re-run of every producer that reads v2/model @ e9cbb88 (D16 amendment; OC-3 host asserts) — model regen, unit TBs, core layer/net/fuzz/checker, post-synth netlist sim, full 10k (10,000/10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
    [cifar10_r2_accuracy.csv, cifar10_r2_summary.csv, cycle_model.csv, final_layer_check.csv, golden_crosscheck.csv, limits_rtl.csv, projection_16x16.csv, reference_accuracy.csv]
2026-09-30 V2 board D19: set pl_clk0 to the bitstream's closed clock after every overlay load and verify the read-back within +-0.1 MHz (gos_driver.set_fclk0_exact: dividers computed first, nothing written if u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
2026-09-30 V2 board D20: clock of record = pl_clk0 PLL read-back for every µs value (RunContext.f_used always f_readback; f_meas recorded beside it as a cross-check only); fcal method fixed — the +1.0 % of the 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
    [power_log.py]
2026-09-30 V2 board: session.sh is the one documented command — re-executes itself under sudo -E when not root and sources /etc/profile.d/pynq_venv.sh as root (PYNQ python3, XILINX_XRT, xclbinutil on PATH; sudo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
    [power_log.py]
2026-09-30 V2 dpu: restore README.md / deploy_dpu.sh to their content before 7bd7173 — v2/dpu is a producer source of dpu_model_accuracy.csv (D16), so the doc-only command edit made its rows stale; the DPU boar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
2026-09-30 V2 results: board Session 1 of 2026-09-30 copied back and archived as 'gos_300 bitstream at 200 MHz' (v2/results/board_20260930_gos300_at_200mhz/: pl_clk0 read back 199.998 MHz, not a 300 MHz result,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
    [hw_b1_power_ina260_phases_sensorcheck.csv, hw_b1_power_ina260_samples_sensorcheck.csv, hw_fclk_cal_s1.csv]
2026-09-30 CLAUDE.md: status after board Session 1 (D19/D20, gos_300 unreachable on the boot-image PLLs, fallback gos_250 at 249.9975 MHz)
2026-09-30 V2 board D21 (B2): sweep the exactly reachable clocks 99.999 / 111.11 / 124.99875 / 142.855714 / 166.665 / 199.998 / 249.9975 MHz (IOPLL 999.99 MHz / 10..4) with the driver's divider-computing setter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
2026-09-30 V2 D16 amendment 2: check_results.py scopes dpu_model_accuracy.csv to the laptop producer code under v2/dpu (excludes *.md, board-side dpu_session.py / deploy_dpu.sh, tests); DPU docs and messages us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
2026-09-30 V2 board: RunContext uses the DEPLOY_INFO entry of the bitstream actually loaded (no false 'loaded bitstream SHA256 != DEPLOY_INFO' warning after the 250 MHz fallback; per-bitstream fields follow the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
2026-09-30 V2 paper (D21): 250 MHz = performance clock (star) run on the KV260; the 300 MHz column of Table I (and the computed-latency row of Table A2) is marked post-implementation only (double dagger) with a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
2026-09-30 V2 results: board Session 1 rerun of 2026-09-30 copied back — gos_300 pre-flight failed (300 MHz unreachable, D19), fallback gos_250 at 249.9975 MHz read-back, all steps OK, fcal -0.0445 % vs read-ba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
    [hw_fclk_cal_s1.csv]
2026-09-30 V2 results: board Session 1 + Session 2 on the KV260 at 249.9975 MHz (gos_250 build fd880d43; 300 MHz build unreachable, D19/D21; scripts+data 89c9f0c, paper_grade) — A2/A3 cycles model==RTL==HW on 2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
    [hw_a1_accuracy.csv, hw_a2_a3_cycles.csv, hw_a4_util.csv, hw_b3_breakdown.csv, hw_b3_breakdown_cpu.csv, hw_b3_breakdown_fast.csv, hw_cpu_baseline.csv, hw_fclk_cal_s1.csv]
2026-09-30 V2 board+paper (D22): onnxruntime 1.19.2 installed in the PYNQ venv (recorded); CPU baseline CSV gets p50/p99, A2 wall-clock p50, B3 p50; B1 CPU condition = ORT INT8 x4 threads (cores 0-3 during CPU 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
2026-09-30 V2 results: board Session 1 + 2 rerun at 249.9975 MHz with onnxruntime 1.19.2 installed (scripts+data 7ef1572, paper_grade) — CPU baselines now ORT FP32/INT8 + numpy FP32 + INT8 ref at 1 and 4 thread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
    [hw_a1_accuracy.csv, hw_a2_a3_cycles.csv, hw_a4_util.csv, hw_b3_breakdown.csv, hw_b3_breakdown_cpu.csv, hw_b3_breakdown_fast.csv, hw_cpu_baseline.csv, hw_fclk_cal_s1.csv]
2026-09-30 V2 results: DPU baseline on the KV260 (Vitis AI 2.5.0 DPUCZDX8G_ISA1_B4096, pynq-dpu 2.5 prebuilt overlay, vai_q PTQ of the same FP32 nets; package @7ef1572, xmodel SHA256 verified) — accuracy 10,000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
    [hw_dpu_accuracy.csv, hw_dpu_latency.csv, hw_dpu_power_ina260_phases_cifar10.csv, hw_dpu_power_ina260_phases_lenet5.csv, hw_dpu_power_ina260_samples_cifar10.csv, hw_dpu_power_ina260_samples_lenet5.csv, hw_dpu_power_ina260_summary_cifar10.csv, hw_dpu_power_ina260_summary_lenet5.csv]
2026-09-30 V2 (D23): paper — DPU in the results tables (A5 rows + DPU/accelerator ratios, p50/p95/p99 + spread table incl. DPU and every CPU config, SOM-rail power compare with own-overlay idle + no-overlay ref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
2026-09-30 V2 power_log: INA260 sampler is a separate process (the thread was starved by the GIL in accelerator/control phases: 1-14 samples per 20-30 s, max gap 3.5-7.8 s; process sampler: 10 Hz, max gap 0.10 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
    [power_log.py]
2026-10-01 V2 board: archive_everything honours the keep list for hw_* result files (the no-overlay idle reference measured before --fresh archiving was moved into archive/); test
2026-10-01 V2 results: board Sessions 1-3 at 249.9975 MHz (scripts 2d280c7, paper_grade, one tmux chain, S1/S2/S3 exit 0) — A1/A2/A3/A4/B3/shapes/CPU/DPU rerun, B1 power (ours+control+CPU per net), B2 clock swe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
    [hw_a1_accuracy.csv, hw_a2_a3_cycles.csv, hw_a4_util.csv, hw_b1_power_ina260_phases_cifar10.csv, hw_b1_power_ina260_phases_lenet5.csv, hw_b1_power_ina260_samples_cifar10.csv, hw_b1_power_ina260_samples_lenet5.csv, hw_b1_power_ina260_summary_cifar10.csv]
2026-10-01 V2 results: board_efficiency.csv (GOPS, images/s per MAC lane / DSP) + dpu_overlay_params.csv (DPU overlay .hwh parameters; DSP/LUT/FF/BRAM counts unavailable from .hwh/.xclbin) from the Sessions 1-3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
    [board_efficiency.csv, dpu_overlay_params.csv]
2026-10-01 V2 board (ssh hygiene): login_spikes.py flags INA260 sample bursts that coincide with an ssh login (and logins inside a power phase); run_sessions ends with an ssh login check (journalctl _COMM=sshd 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
2026-10-01 V2 board (B2 rigor): clock order is a seeded random permutation (--order-seed, recorded; --order ascending = old), die temperature (PL/PS/remote) logged at the start and end of every power phase and 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
2026-10-01 V2 DPU: dpu_session rows carry the measurement environment (session_index, env_step, paper_grade, governor, ... from $GOS_RUN_ENV via board_common.env_meta). The 2026-09-30 DPU rows had paper_grade='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
2026-10-01 V2 analysis (per-lane efficiency): board_efficiency.py states the exact formulas (formula column), the lane clock with its source file (ours: pl_clk0 read-back of the A2 run; DPU: aclk = 300 MHz from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
2026-10-01 V2 results: board_efficiency.csv with the lane clock / peak / formula columns (derived from the committed Sessions 1-3 board results)
    [board_efficiency.csv]
2026-10-01 V2 results: re-run the three stale analysis producers (schedule_ablation, projection_16x16 [projected, not C1], utilization_model + .md) at HEAD — values identical, only row provenance (commit) moves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
    [projection_16x16.csv, schedule_ablation.csv, utilization_model.csv]
2026-10-01 V2 board (idle reference guard): the no-overlay idle reference is refused when this boot already loaded a bitstream (fpga_manager kernel log count != 0). The 2026-10-01 05:24 10-min 'reference' read 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
2026-10-01 V2 results: DPU baseline re-run as the orchestrated step s2.DPU at 28d0602 (rows now paper_grade=True, session_index/env_step set; INA260 SOM-rail idle/accel/idle x3 per net, p50/p95/p99, accuracy 10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
    [hw_dpu_accuracy.csv, hw_dpu_latency.csv, hw_dpu_power_ina260_phases_cifar10.csv, hw_dpu_power_ina260_phases_lenet5.csv, hw_dpu_power_ina260_samples_cifar10.csv, hw_dpu_power_ina260_samples_lenet5.csv, hw_dpu_power_ina260_summary_cifar10.csv, hw_dpu_power_ina260_summary_lenet5.csv]
2026-10-01 V2 results: board_efficiency.csv re-derived from the re-run DPU rows
    [board_efficiency.csv]
2026-10-01 V2 board (system-activity check): login_spikes.service_windows/analyse_windows + run_sessions end-of-run check flag every power phase overlapping an apt-daily / apt-daily-upgrade / PackageKit / unatt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
2026-10-01 V2 results: B2 clock sweep re-run at e91657a — seeded random clock order (seed 966258), die temperature per phase, temperature-covariate fit; no ssh login and no apt/PackageKit window overlapped a po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
    [hw_b2_clock.csv, hw_b2_cycles.csv, hw_b2_fit.csv, hw_b2_power_ina260_phases_lenet5_100mhz.csv, hw_b2_power_ina260_phases_lenet5_111mhz.csv, hw_b2_power_ina260_phases_lenet5_125mhz.csv, hw_b2_power_ina260_phases_lenet5_143mhz.csv, hw_b2_power_ina260_phases_lenet5_167mhz.csv]
2026-10-01 V2 paper: efficiency table notes — numbers (2, 100, DPU aclk 300 MHz, ap_clk_2 600 MHz) come from the CSV / formula labels so the provenance guard passes (make_all FAILED after the item-6 wording cha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
2026-10-01 V2 paper: efficiency table notes — numbers (2, 100, DPU aclk 300 MHz, ap_clk_2 600 MHz) come from the CSV / formula labels so the provenance guard passes (make_all FAILED after the item-6 wording cha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
2026-10-01 V2 board: service_windows closes a unit window on 'Stopped X' (PackageKit idle exit / manual stop); test
2026-10-01 CLAUDE.md: board apt-daily timers / packagekit masked for the experiment period, with the re-enable commands for after submission
2026-10-01 V2 results: archive the first (ascending-order, 2d280c7) B2 fit as hw_b2_fit_ascending_superseded.csv (copied from f547f7f, unmodified rows) so the paper can state the sweep-to-sweep difference with 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
    [hw_b2_fit_ascending_superseded.csv]
2026-10-01 V2 paper: B2 table uses the randomized sweep (hw_b2_fit.csv) and states that the two clean sweeps' k differ by 8 % (P_accel), 22 % (dP_accel), 14 % (P_idle) — computed from the CSVs, not typed; the d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
2026-10-01 V2 results: repeatability session_index 2 (latency B3 safe/fast/CPU, CPU baselines incl. ORT INT8, B1 power both nets, fcal; scripts e91657a, paper_grade, results/rep2/, sha256 verified; end-of-run c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
    [hw_b1_power_ina260_phases_cifar10.csv, hw_b1_power_ina260_phases_lenet5.csv, hw_b1_power_ina260_samples_cifar10.csv, hw_b1_power_ina260_samples_lenet5.csv, hw_b1_power_ina260_summary_cifar10.csv, hw_b1_power_ina260_summary_lenet5.csv, hw_b3_breakdown.csv, hw_b3_breakdown_cpu.csv]
2026-10-02 V2 results: repeatability session_index 3 (same scope as index 2: B3 safe/fast/CPU, CPU baselines incl. ORT INT8, B1 power both nets, fcal; scripts e91657a, paper_grade, results/rep3/, sha256 verifie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
    [hw_b1_power_ina260_phases_cifar10.csv, hw_b1_power_ina260_phases_lenet5.csv, hw_b1_power_ina260_samples_cifar10.csv, hw_b1_power_ina260_samples_lenet5.csv, hw_b1_power_ina260_summary_cifar10.csv, hw_b1_power_ina260_summary_lenet5.csv, hw_b3_breakdown.csv, hw_b3_breakdown_cpu.csv]
2026-10-02 V2 results: hw_repeatability.csv (aggregate_sessions.py over session_index 1-3, 245 metric groups; inputs rep2/rep3 @ e91657a, index 1 @ 2d280c7)
    [hw_repeatability.csv]
2026-10-02 V2 paper pipeline: board numbers are the median over the three board sessions with across-session spread (min/max in brackets, CV for power); analysis/session_median.py (shared merge: rows matched by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
2026-10-02 V2 results: board_efficiency.csv from the session medians (B3 safe/fast end-to-end p50, best-CPU compute/e2e median over the three board sessions; PL counter, DPU unchanged)
    [board_efficiency.csv]
2026-10-02 V2 paper: CPU table lists ORT rows first (primary) and the numpy rows below a rule with a dagger footnote (unoptimized, brackets shown); REPRODUCE.md and CLAUDE.md point at tag v2-paper-final
2026-10-02 V2 paper pipeline: single-column paper tables tab_compare (ours / DPU / best CPU per net: e2e p50, SOM-rail energy, speedup vs best CPU) and tab_impl_compact (250 MHz build, 300 MHz as a note); tab_p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
2026-10-02 V2 paper: draft revised to 4 pages incl. references (single-column Table I = tab_impl_compact, Table II = tab_compare; Fig. 1 in TikZ; Fig. 2 dropped; sections cut to word targets; one utilization me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
2026-10-02 V2 paper: lessons-learned paragraph (silent 200 MHz clock / 300 MHz PLL limit, GIL-starved power sampler, login/OS-update overlap checks, KW limit; sources DECISIONS D19/D23/D24/OC-3 + commits e91657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
2026-10-02 V2 DECISIONS D27: record of the 2026-10-01 OS-update incident (unattended upgrade 06:34:59-06:40:38 UTC inside the first random-order B2 attempt, attempt discarded and sweep re-run at e91657a / d2604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
2026-10-02 V2 paper: review revision (abstract with core size, energy and PL-attributable dP, DPU CIFAR-10 result mid-sentence; 'no stall cycles, stall counter 0 on every recorded board job' in Sec. IV; indepen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
2026-10-03 V3 phase 0 WS5: exploratory feasibility RTL (PE row W=16/32 with/without INT8 DSP packing; URAM weight + banked ACT + residual-into-requant memory path), self-checking xsim TBs, exhaustive packing mo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
2026-10-03 V3 phase 0: WS1 literature (refs.bib, LITERATURE.md, literature.csv), WS3 DPU/ORT baseline flow + board baseline session (dry-run ready), WS4 extended cycle model + memory estimate + DSE driver; feas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
    [literature.csv]
2026-10-06 V3 research: interim novelty-check outputs (t1-t6 subagent findings, merged related list, independent reference re-check); final NOVELTY/VENUES pending
    [merged_related.csv, t1_related.csv, t2_related.csv, t3_related.csv, t4_related.csv, t5_prior_numbers.csv, t5_related.csv, t6_venues.csv]
2026-10-06 V3 plan: docs/V3_PLAN.md (thesis, milestones M1-M5, dropped/conditional, one-bitstream descriptor rule, verification, 3 board sessions, evaluation, training, inherited rules, Phase 0 status with the 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
2026-10-06 V3 research: 50-paper literature survey (7 categories: ZU+ CNN accelerators 10, flexible dataflow 8, sparsity skipping 8, timing-predictable inference 7, performance models/DSE 6, INT8/DSP packing/de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
    [c1.csv, c2.csv, c3.csv, c4.csv, c5.csv, c6.csv, c7.csv, exclusions.csv]
